ECE411Team15/Speedometer/logs/Images/IMG_20171129_233830.jpg

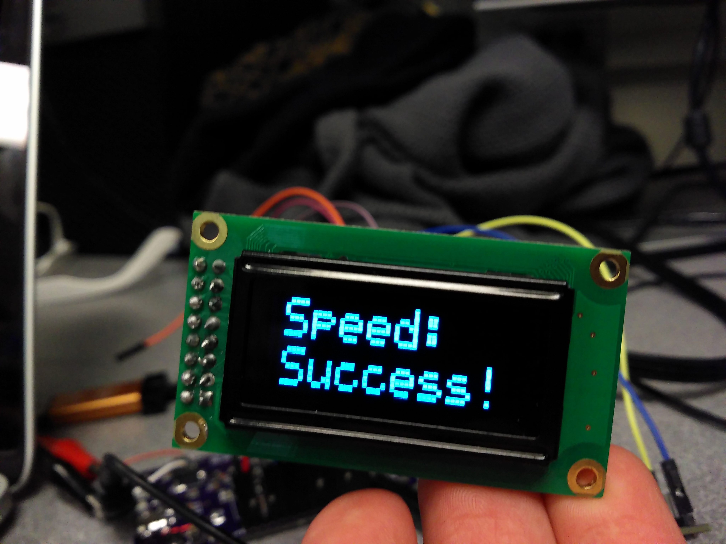
logs/Images/IMG_20171129_233830.jpg
