ECE411Team15/Speedometer/logs/Images/056.jpg

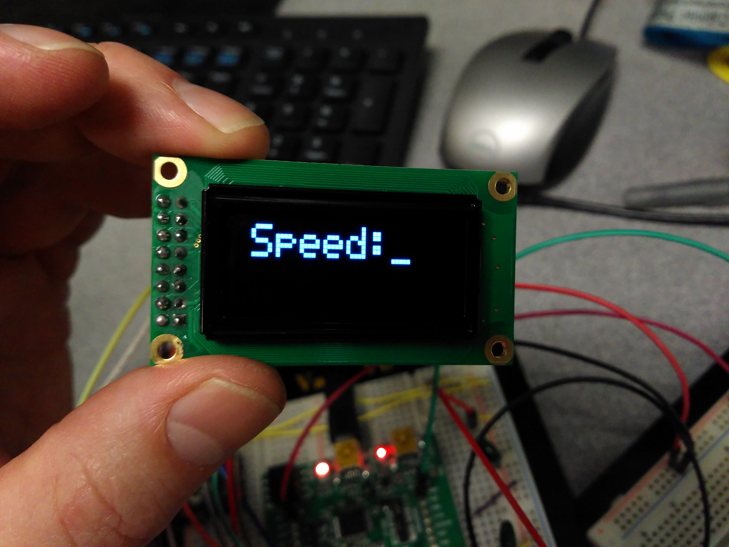
logs/Images/056.jpg
