ECE411Team15/Speedometer/README.md

# Speedometer
ECE 411, Fall 2017, Speedometer project.
