ECE411Team15/Speedometer/link_to_schematic.txt

https://github.com/ECE411Team15/Speedometer/blob/master/EagleCAD/SpeedDemon/Schematic.sch
