ECE411Team15/Speedometer/EagleCAD/On_circuit_timing/proof-of-concept_README.txt

The low voltages at the 'switching' node represent button presses. Notice the momentary press of ~0.4s is sufficient to turn the output voltage on, but not enough to turn it off. Here, the circuit turns off after a ~1.6s press, but it could be made longer or shorter depending on choice of C3 and R3.
The circuit drives the EN input of the voltage regulator, so it will draw almost no current either on or off.

-ZS

NOTE: This circuit is from a commercial site* and we may want to clear its use with Prof. Greenberg.

*source: http://www.mosaic-industries.com/embedded-systems/microcontroller-projects/electronic-circuits/push-button-switch-turn-on/latching-toggle-power-switch

*http://www.mosaic-industries.com/embedded-systems/_detail/microcontroller-projects/electronic-circuits/push-button-switch-turn-on/latching-high-side-toggle-switch-ci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
