ECE411Team15/Speedometer/project_requirements_v1.0.docx

Project Requirements: The Speed Demon

[*If we want to call this something else that’s fine, I just don’t think ‘Speedometer’ is going to cut it. -ZS]

Authors: Linyi Hong, Zachary Stamler, Nathan Dusciuc, Andrew Capatina

Version Number: 1.0

Date Created: 10/15/2017

Needs Statement:

With an infrastructure that supports 350 miles of bikeways, Portland, Oregon is one of the friendliest cities for non-motorized transportation. In Portland, 7.2% of commuters travel by bike. Skateboarding remains a popular pastime, and since the year 2000, skaters there have enjoyed the same legal status as cyclists. Curious bikers may need to know how fast they are moving for many reasons, including safety and timing commutes. Skaters may need to know their speed for completing a jump or for longboarding purposes. The fitness-conscious like to keep track of their distance travelled, and thrill seekers always want to know how fast they are moving. For all these reasons, an adaptable system is needed to record the speed, along with other statistics, of a moving bike or skateboard.

*Statistics provided by the Portland Bureau of Transportation.

Objective Statement:

Our objective is to provide a battery powered device that will display speed for bikes, skateboards, and other wheeled conveyances. The device should work with vehicles with differing wheel diameters, and will be able to switch modes for different units of speed. The user will be able to interact with the device via mode-switch buttons. It will then display the appropriate information on the integrated screen.

Requirements:

Functionality

- Modular, end user-replaceable, chassis mounted Hall effect sensor pairs with wheel-mounted magnet, interfaces with main unit via connector
- Display screen on head unit with large character size, visible in variety of lighting conditions
- Based around STM32F0xxx family MCU
- Head unit must have small form factor, suitable for mounting on bike handlebars or front of skate deck
- Parameterizable, nonvolatile memory stored wheel diameter, ideally with space for several different vehicle specs to allow different modes for different vehicles
- Modes and data entry controllable with two- or three-pushbutton interface

Performance

- Magnet/sensor combination strong enough to leave sensible air gap (~1 cm) between them
- Works at high wheel speeds, up to and exceeding ~30 MPH for small-diameter (i.e. skateboard-sized) wheels. [*Nathan, please check/elaborate on my numbers here! -ZS]
- Battery powered, with power consumption low as possible to restrict size and prolong battery life. Ideally should run on coin battery.
- Water-resistant enough to withstand regular rainy conditions

Economic/Marketing

- Retail cost of device not to exceed $60
- Wheel sensor unit can be sold separately with differing cable lengths and mounting brackets (‘Bike Sensor Kit’, ‘Skate Sensor Kit’, etc)
