ECE411Team15/Speedometer/Presentation/Team15_Presentation_3.0.pptx

## Speed Demon Speedometer

Team15
Andrew Capatina, Zachary Stamler
Nathaniel Dusciuc, Linyi Hong

## Problem/Need

- A simple effective way of measuring speed on a human powered device
  - No off-the-shelf alternatives for skateboards or longboards
  - Cyclists and skateboarders like to measure their own performance and want a device that can do this easily.

To speak: Nathan

## Motivation

- Device allows the user to know their speed
- Dedicated device frees up hands for rider safety
- Allows installation on bicycle, skateboard, longboard, or any other wheeled conveyance
- One device can be used for multiple vehicles

To speak: Nathan

## Objective

- A working prototype that serves as a proof of concept and allows testing of device functionality

To speak: Nathan

## Alternatives

- GPS
  - Dependant on GPS signal
  - Often inaccurate at low speeds
  - Require expensive device or smartphone
- Bicycle speedometers
  - Off-the-shelf speedometers exist for bicycles but they are not compatible with skateboards or other vehicles

To speak: Nathan

## Requirements

- Device measures wheel rotations and displays speed on a screen
- User can choose different units for displayed speed
- User can set wheel size for use with different vehicles
- Device is battery powered

To speak: Nathan

## Approach

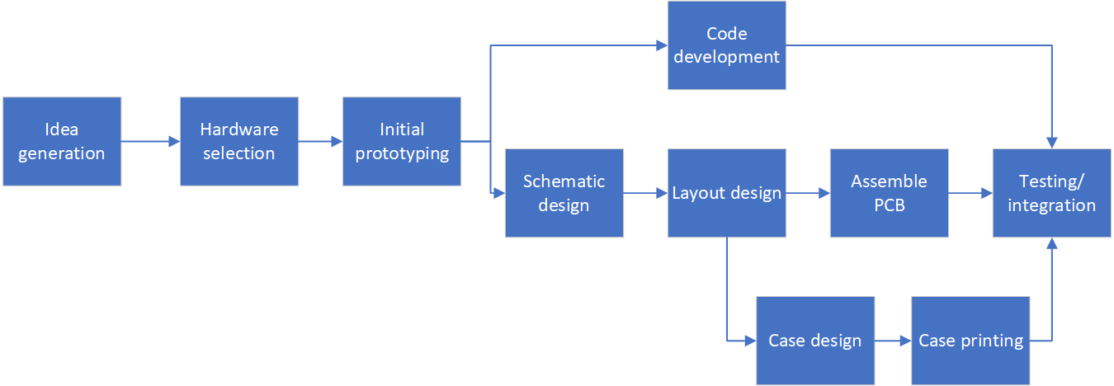
[picture p3: figure]

To speak: Nathan

## Prototyping

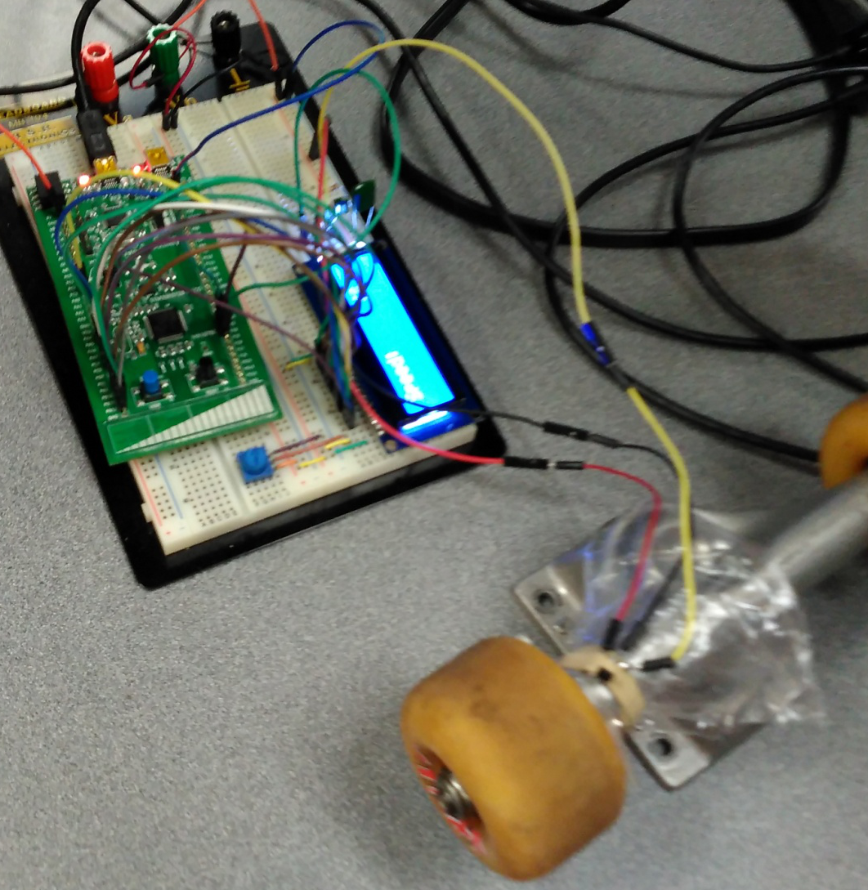
[picture p4: figure]

To speak: Nathan

## Design - Hardware

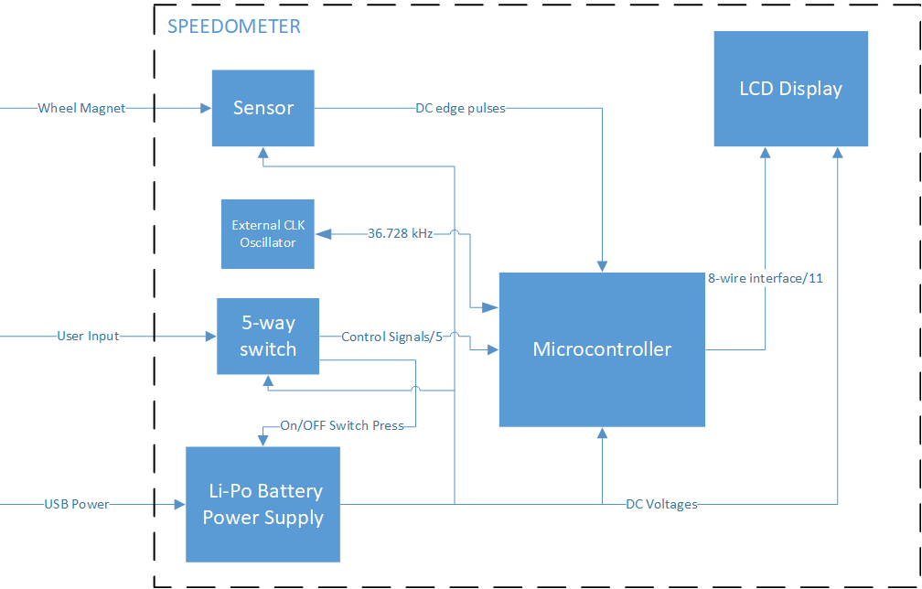
[picture p5: figure]

To speak: Zach

## Slide 10

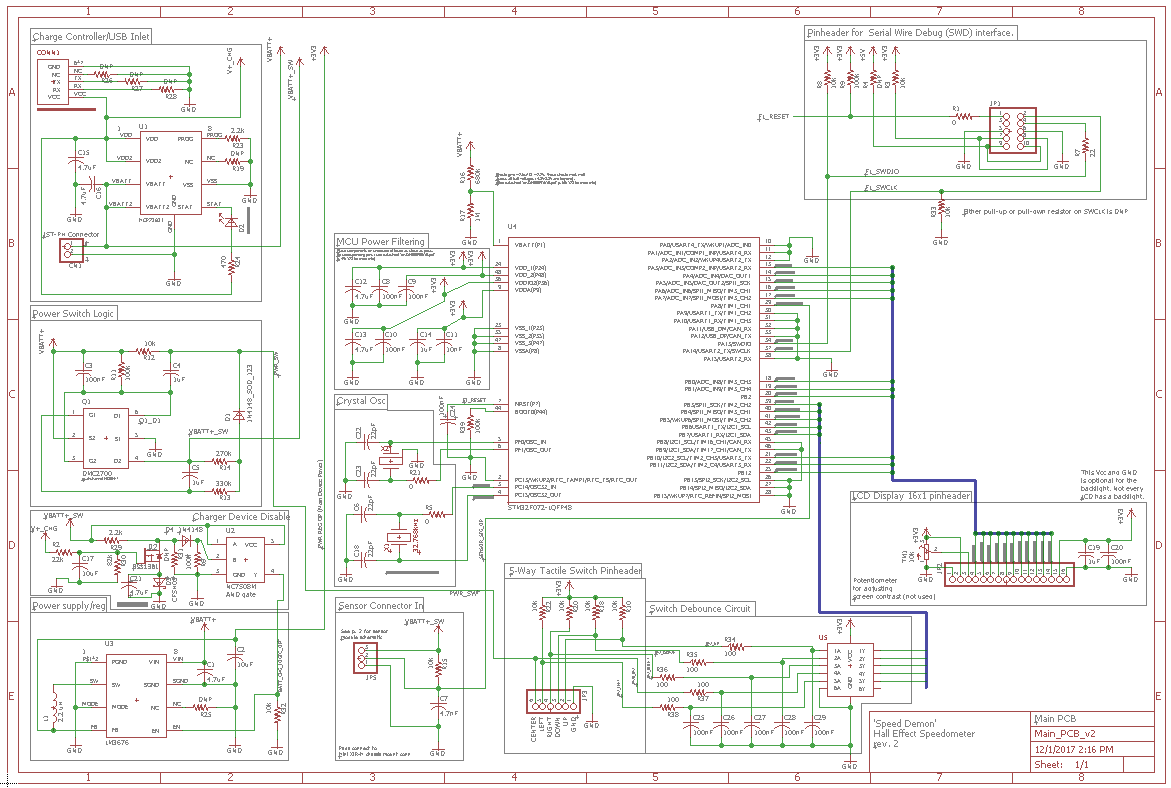
[picture p6: figure]

Schematic

To speak: Zach

## Hardware PCB Layout

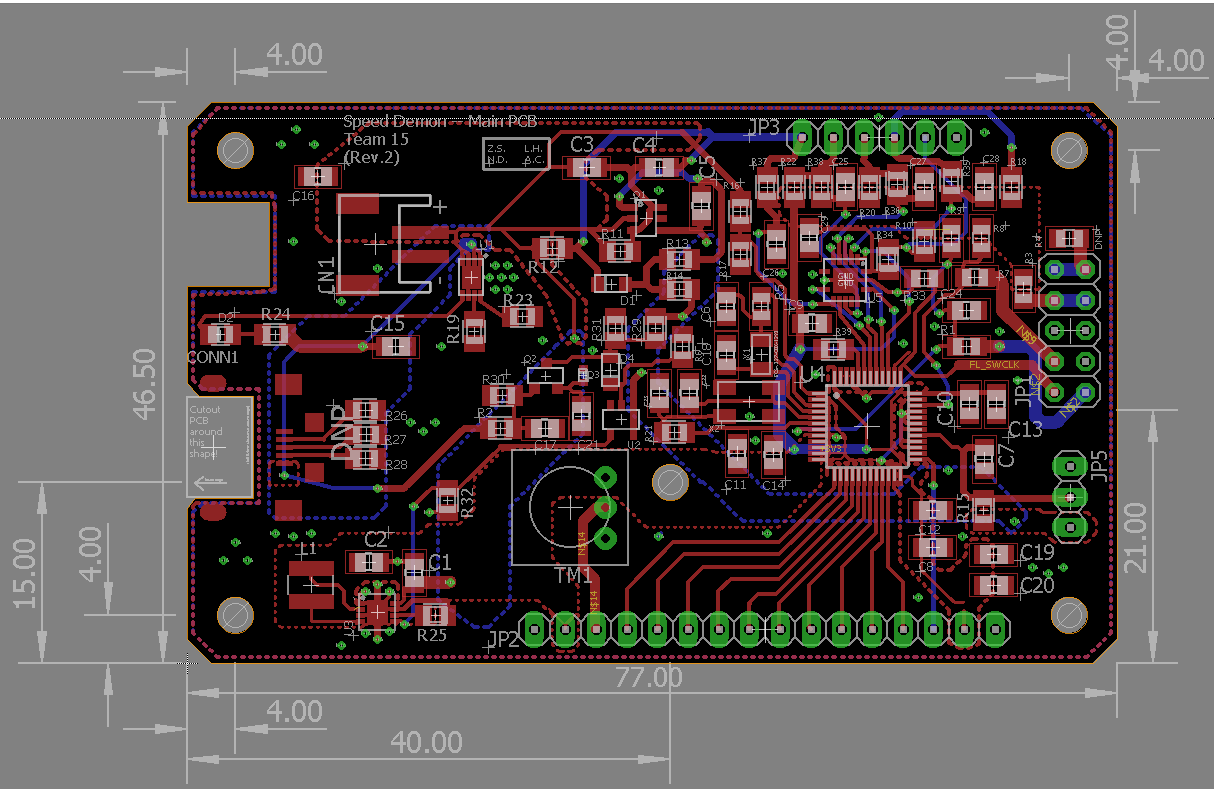
[picture p7: figure]

To speak: Zach

## High Level Software Implementation

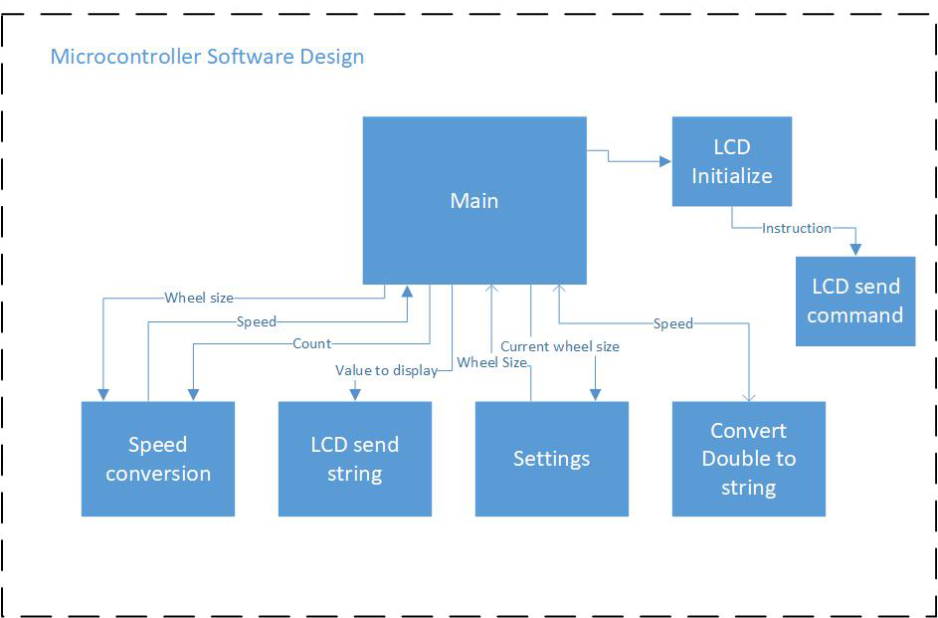
[picture p8: figure]

To speak: Andrew

## Software Implementation - User Program

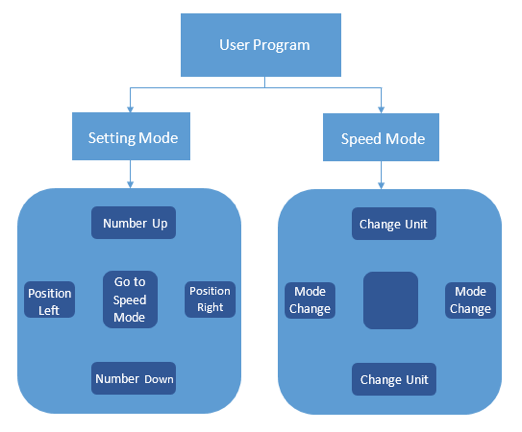
[picture p9: figure]

To speak: Andrew

## Design Alternatives?

Module | Option 1 | Option 2
Speed Conversion | Polling Hall Effect Sensor Input | Interrupts (input capture)
Settings | Polling button inputs | Interrupts

What are the tradeoffs?
- Polling requires extra effort for timing
  - Not utilizing available resources as well
Decisions Made:
- Speed Conversion: option 2
- Settings: option 2

To speak: Andrew

## Software Development Tools

- MCU hardware configuration:
  - STM32CubeMX
- Compiler/debugger
  - Keil uVision IDE.
- Development Board
  - STM32F072B-DISCOVERY

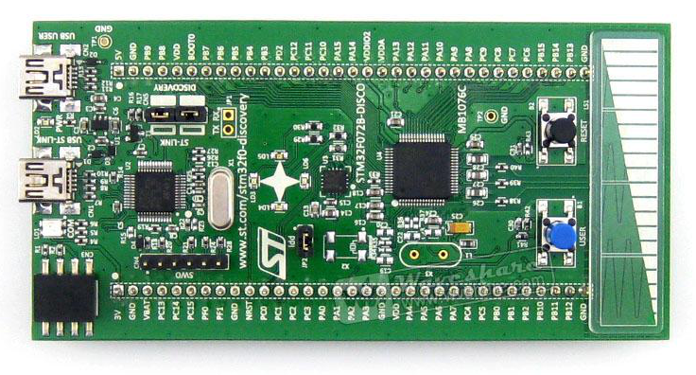
[picture p10: figure]

To speak: Andrew

## Work referenced for Software

- Patrick Hood-Daniel
  - Provided program structure for OLED program.
- Le Tan Phuc
  - Provided tutorial on how to initialize input capture.
- Links:
  - https://letanphuc.net/2015/06/stm32f0-timer-tutorial-and-counter-tutorial/ (https://letanphuc.net/2015/06/stm32f0-timer-tutorial-and-counter-tutorial/)
  - https://www.youtube.com/watch?v=micDbBN9s9k&list=PL6PplMTH29SHbfyqpSqn-2gyJZtuwzEqs

To speak: Andrew

## Bill of Materials…

To speak: Linyi

## Testing

1. Bring up sub-circuits in sequence and verify correct functionality of each.
2. Interface MCU and test dummy code.
3. Integrate hardware modules with fully functioning code.

To speak: Linyi

## Software Test Plan

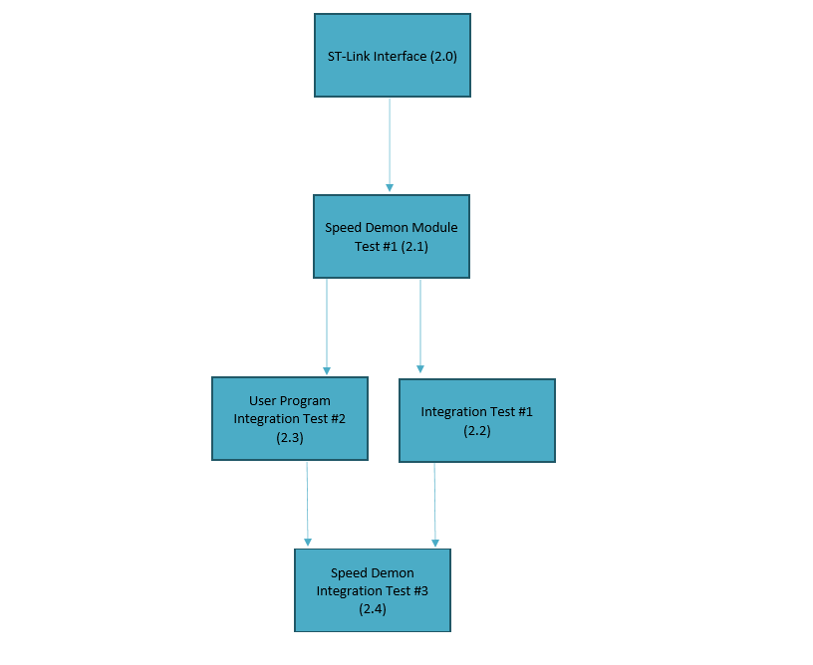
[picture p11: figure]

To speak: Linyi

## Results

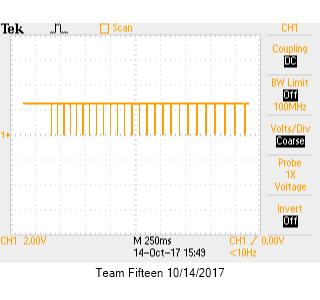
[picture p12: figure]

Hall effect sensor prototyping

To speak: Linyi

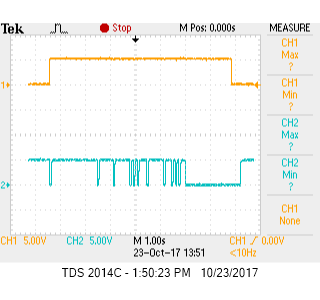
[picture p13: figure]

On-button prototyping

## Slide 21

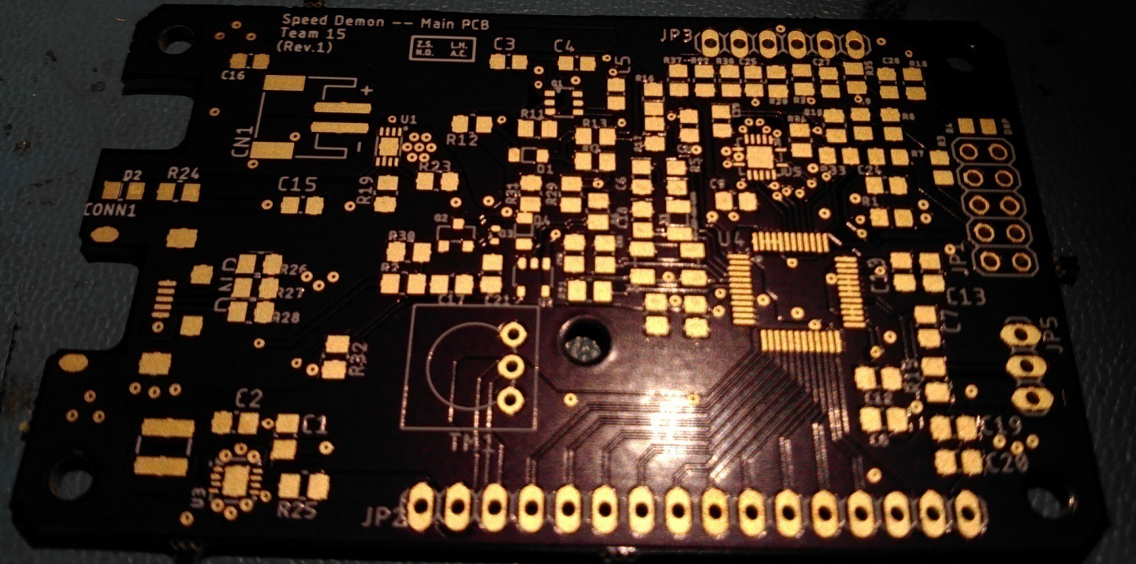
[picture p14: figure]
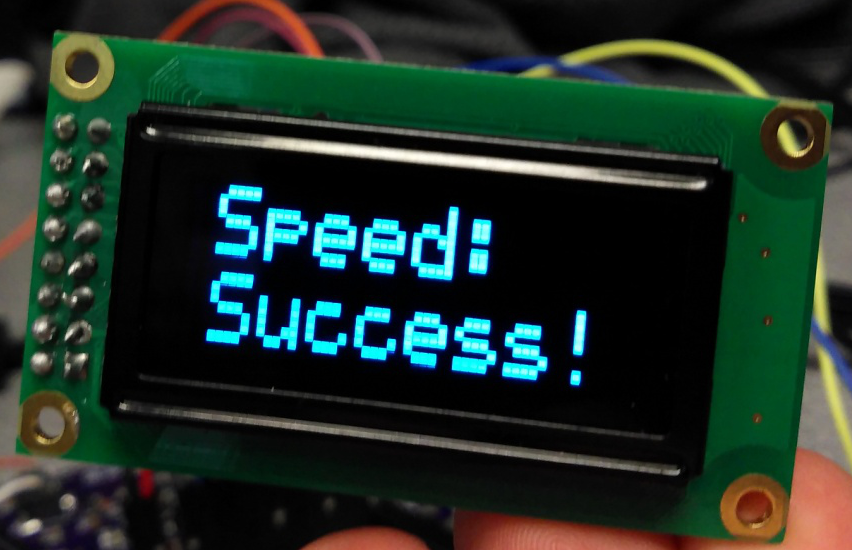
[picture p15: figure]

To speak: Linyi

## Contributions

- N.D.
- Hardware design
- Schematic and layout
- Part sourcing
- Testing
- Board bring up

To speak: Linyi

- Z.S.
- Hardware design
- Schematic and layout
- EagleCAD custom parts
- Part sourcing
- Testing
- Board bring up

- A.C.
- Software Design
- Part sourcing
- Testing software
- speedDemon software integration

- L.H.
- Software design
- Testing software
- Hardware design
- Case design

## Lessons Learned?

To speak: All
