ECE411Team15/Speedometer/Presentation/Team15_Presentation_2.0.pptx

## Speed Demon Speedometer

Team15
Andrew Capatina, Zachary Stamler
Nathaniel Dusciuc, Linyi Hong

## Problem/Need

- A simple effective way of measuring speed on a human powered device
  - No off-the-shelf alternatives for skateboards or longboards
  - Cyclists and skateboarders like to measure their own performance and want a device that can do this easily.

To speak: Nathan Dusciuc

## Motivation

- Device allows the user to know their speed
- Dedicated device frees up hands for rider safety
- Allows installation on bicycle, skateboard, longboard, or any other wheeled conveyance
- One device can be used for multiple vehicles

To speak: Nathan Dusciuc

## Objective

- A working prototype that serves as a proof of concept and allows testing of device functionality

To speak: Zach Stamler

## Alternatives

- GPS
  - Dependant on GPS signal
  - Often inaccurate at low speeds
  - Require expensive device or smartphone
- Bicycle speedometers
  - Off-the-shelf speedometers exist for bicycles but they are not compatible with skateboards or other vehicles

To speak: Zach Stamler

## Requirements

- Device measures wheel rotations and displays speed on a screen
- User can set wheel size for use with different vehicles
- User can choose different units for displayed speed
- Device is battery powered

To speak: Zach Stamler

## Approach


To speak: Linyi Hong

## Software Development Test Rig


To speak: Andrew Capatina

## Design - Hardware


To speak: Nathan Dusciuc

## Slide 10


Schematic

To speak: Zach Stamler

## High Level Software Implementation


To speak: Andrew Capatina

## Software Implementation - User Program


To speak: Linyi Hong

## Design Alternatives?

Module | Option 1 | Option 2
Speed Conversion | Polling Hall Effect Sensor Input | Interrupts (input capture)
Settings | Polling button inputs | Interrupts

What are the tradeoffs?
- Polling requires extra effort for timing
  - Not utilizing available resources as well
Decisions Made:
- Speed Conversion: option 2
- Settings: option 2

To speak: Andrew Capatina

## Hardware PCB Layout


To speak: Zach Stamler

## Software Development Tools

- MCU hardware configuration:
  - STM32CubeMX
- Compiler/debugger
  - Keil uVision IDE.
- Development Board
  - STM32F072B-DISCOVERY


To speak: Andrew Capatina

## Work referenced for Software

- Patrick Hood-Daniel
  - Provided program structure for OLED program.
- Le Tan Phuc
  - Provided tutorial on how to initialize input capture.

To speak: Andrew Capatina

## Bill of Materials…

To speak: Nathan Dusciuc

## Testing

1. Bring up sub-circuits in sequence and verify correct functionality of each.
2. Interface MCU and test dummy code.
3. Integrate hardware modules with fully functioning code.

To speak: Linyi Hong

## Software Test Plan


To speak: Andrew Capatina

## Results


Hall effect sensor prototyping

To speak: Nathan Dusciuc


On-button prototyping

## Slide 21


## Contributions

- N.D.
- Hardware design
- Schematic and layout
- Part sourcing
- Testing
- Board bring up

- Z.S.
- Hardware design
- Schematic and layout
- EagleCAD custom parts
- Part sourcing
- Testing
- Board bring up

- A.C.
- Software Design
- Part sourcing
- Testing software
- speedDemon software integration

- L.H.
- Software Design
- Testing Software
- Hardware design
- Case Design

## Lessons Learned?

- Andrew Capatina: slow down, show more confidence in problem solving.
- Communication is key when working with others to implement software

To speak: All
