ECE411Team15/Speedometer/WPRs/wk09_Dusciuc_WPR.docx

# Weekly Report

Nathaniel Dusciuc

Week 9

11/27/17

# What I did:

- Wrote hardware test cases with Zach.
- Helped Andrew debug issue with input sampling time and speed conversion formula.
- Ordered female/female jumper wires from Adafruit.
- Received PCBs from OSH Park.
- Received Li-Po batteries from Adafruit.

# Issues:

- We need joystick caps for our 5-way tactile switches.

# Next Steps:

- Bring up PCB.
- Finish test plan for homework 7
- Help design case enclosure.
