ECE411Team15/Speedometer/WPRs/wk08_Dusciuc_WPR.docx

# Weekly Report

Nathaniel Dusciuc

Week 8

11/20/17

# What I did:

- Soldered sic 5-way tactile switches to six breakout boards.
- Ordered four Lithium polymer batteries and six right-angle JST-PH battery connectors.
- Tested sensor modules in the housing that Zach made.
- Helped Linyi and Andrew with prototyping.
- Ordered resistors and capacitors with Zach.

# Issues:

- We need joystick caps for our 5-way tactile switches.

# Next Steps:

- Bring up PCB.
- Write test plan for homework 7.
- Order female/female jumpers for assembling LCD screens to main PCBs.
