ECE411Team15/Speedometer/WPRs/wk07_Dusciuc_WPR.docx

# Weekly Report

Nathaniel Dusciuc

Week 7

11/12/17

# What I did:

- Zach and I finished the board layout.
- I created block diagrams of our project for the “Detailed Design” homework assignment.
- Zach and I tried to solder some components for prototyping but the components are too small.
- Purchased red-wire for prototyping/debugging.

# Next Steps:

- Help Andrew and Linyi with prototyping.
- Solder 5-way tactile switches to their breakout boards for prototyping.
- Review pinout with team and modify eaglecad files as needed.
