ECE411Team15/Speedometer/WPRs/wk06_Dusciuc_WPR.docx

# Weekly Report

Nathaniel Dusciuc

Week 6

11/4/17

# What I did

- I helped Zachary revise the schematic and verify a final version.
- I met with my team and we completed our project plan using Microsoft project.
- I did a breakout board layout for the 5-way tactile switch we will be using. Zachary ordered the board from OSHPark.
- I started the preliminary board layout for our main board.
- Purchased six 5-way tactile switches from Sparkfun.
- Purchased two 1x40 headers from EPL.

# Next Tasks

- Work with Zachary to complete a preliminary board layout.
- Work with my team to create a block diagram depicting the inputs and outputs of our design.
- I need to order more key components for further prototyping.
