ECE411Team15/Speedometer/WPRs/wk05_Dusciuc_WPR.docx

# Weekly Report

Nathaniel Dusciuc

Week 5

10/29/17

# What I did

Zachary and I finished the draft of the schematic.

I helped Andrew build a prototype of our product using the STM32 development board.

I worked with Zachary and Linyi to finish the decision matrix document for the homework assignment.

# Next Tasks

I need to revise the schematic and create a final version.

We need to collaborate as a team to create a Microsoft project document showing our plan.
