ECE411Team15/Speedometer/logs/Ways to flash the MCU.docx

Ways to flash the MCU:

# Serial Wire Debug (SWD) (Use ST-link V2) （Recommend, design for STM32）

# Actually, one common way to interface chips is JTAG, which require 20 lines:

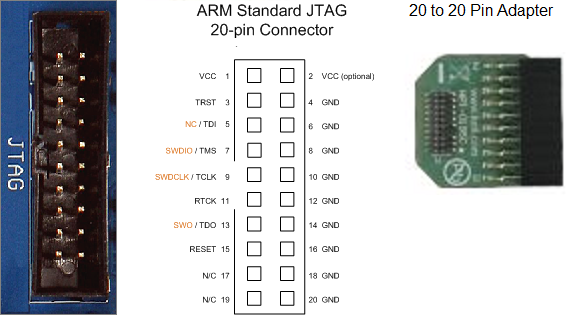
[picture p16: figure]
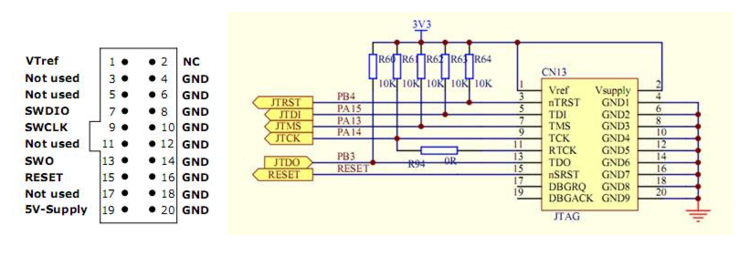
[picture p17: figure]

But JTAG connector is very expensive, so when we use STM32, we can use another interface way which can also done in JTAG. It called Serial Wire Debug (SWD). SWD is an alternative 2-pin electrical interface that uses the same protocol. It uses the existing GND connection. On JTAG devices with SWD capability, the TMS and TCK are used as SWDIO and SWCLK signals, providing for dual-mode programmers.

# SWD only requires 4 lines:

# Transferring data must use three wire: SWDIO, SWCLK and GND (common ground with the MCU). VDD pins make MCU and ST-link board common VDD. Reset is reset….

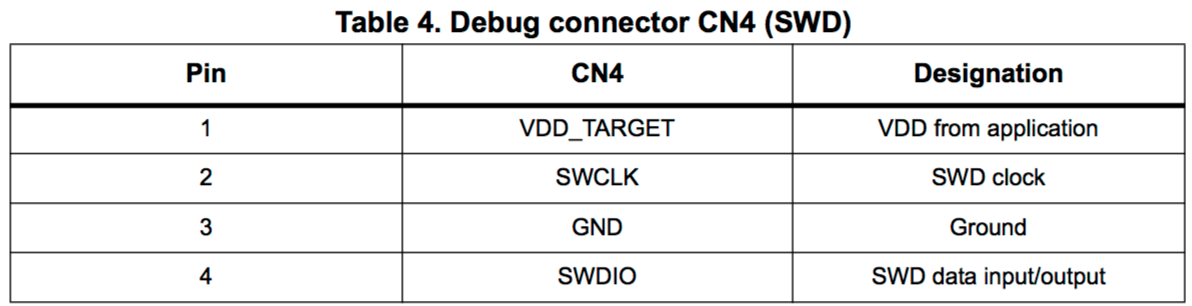
[picture p18: figure]

# We don't need SWO here.

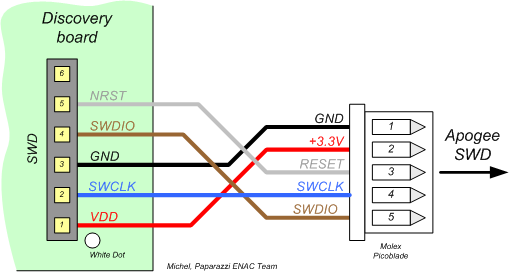
[picture p19: figure]

# I found a lot of schematic on the internet, some schematics for the SWD part connect 10k resistors. But some just connect them directly. The pictures are showing below,

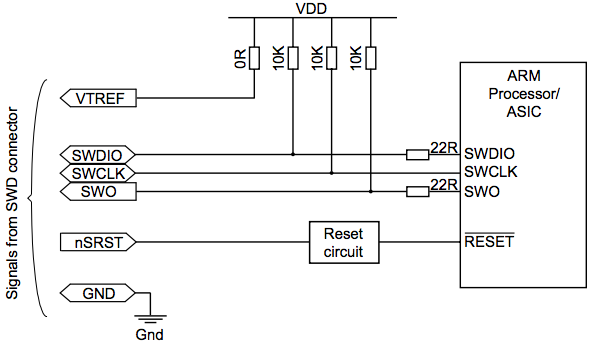
[picture p20: figure]

# Current requirement for VDD(3.3) is no more than 300mA, VDD(5V) is no more than 400mA.

Component: https://www.adafruit.com/product/2548?gclid=EAIaIQobChMI0-69o7T51gIVDzNpCh2flQ4BEAQYAiABEgIE7_D_BwE

and download the drive (st-link_v2_usbdriver.exe) and specific software (STM32 ST-link Utility).

# Serial interface (Use CH340G)

Component: http://www.dx.com/p/stc-stm32-ch340g-upgraded-usb-to-ttl-downloader-green-389333#.WecN3hNSxHU (do not include BOOT0 pin)

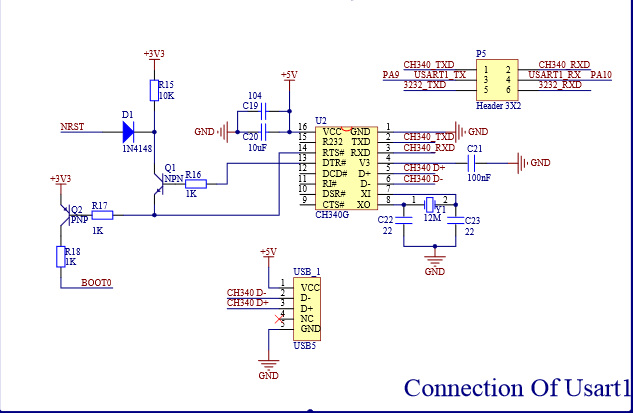
[picture p21: figure]

and download the drive and specific software on computer to load the code.

But both ways we need to find out a way to control BOOT0 pin on MCU to make sure the mode is right.

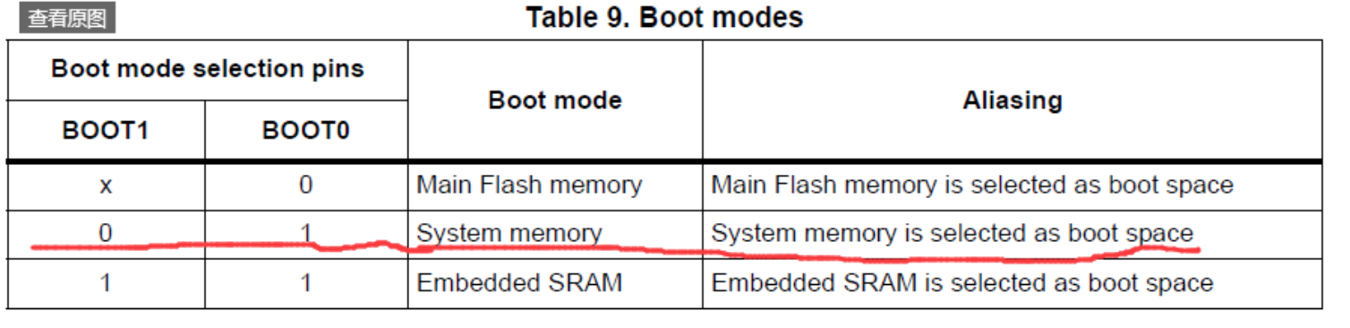
[picture p22: figure]
