ECE411Team15/Speedometer/Case/Mechanicals for case design/images_LOOK_HERE_FIRST/battery.pdf

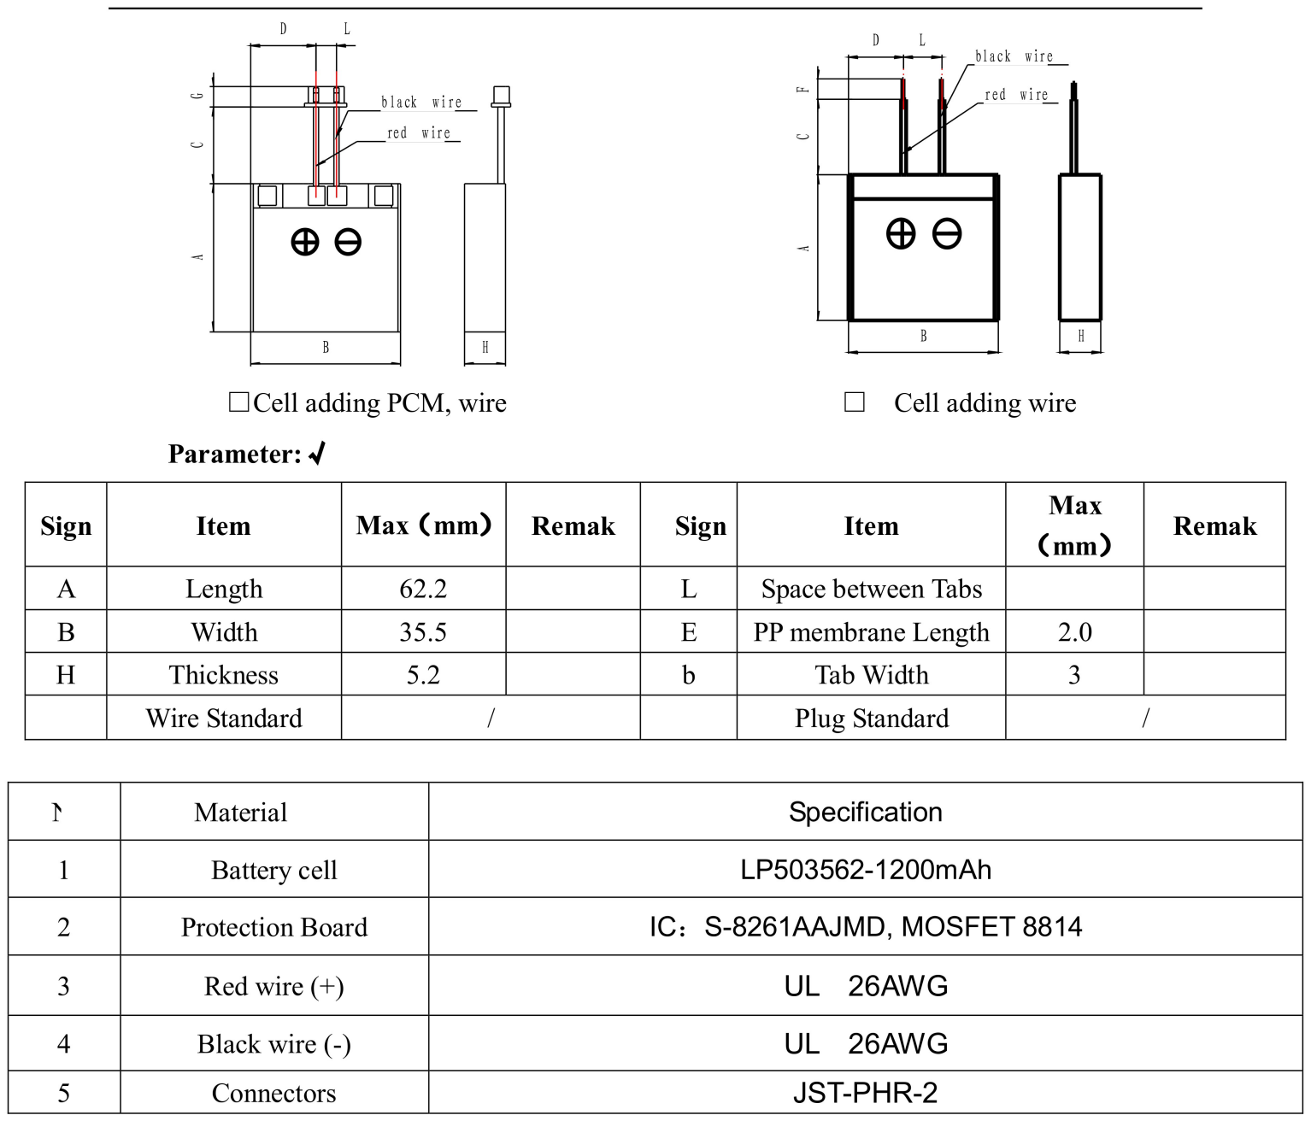
[picture p28: page 1]
