ECE411Team15/Speedometer/Block diagram.PNG

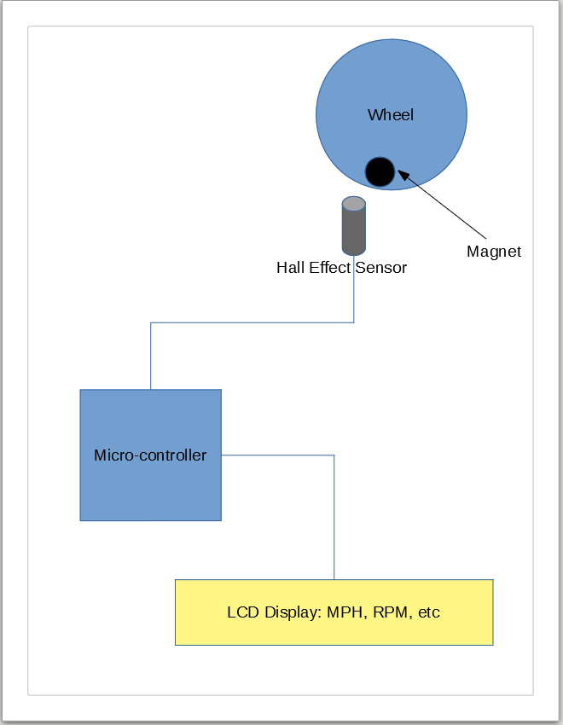
Block diagram.PNG
