ECE411Team15/Speedometer/Case/Mechanicals for case design/images_LOOK_HERE_FIRST/Main_PCB.png

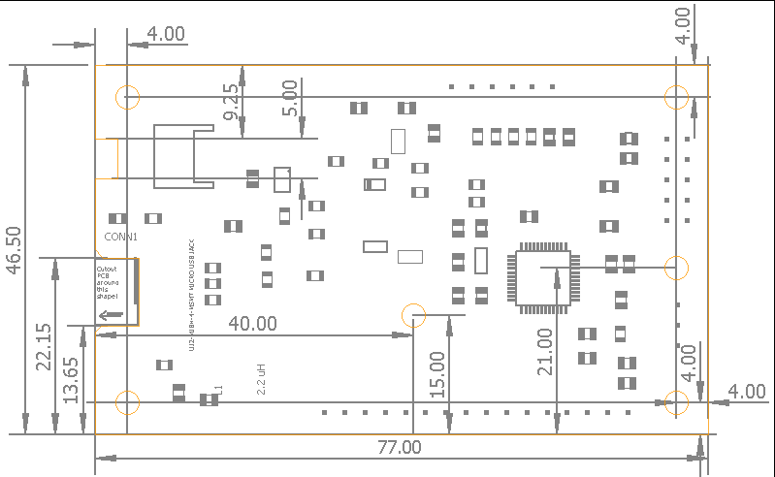
Case/Mechanicals for case design/images_LOOK_HERE_FIRST/Main_PCB.png
