ECE411Team15/Speedometer/Case/Mechanicals for case design/images_LOOK_HERE_FIRST/tactile_switch.png

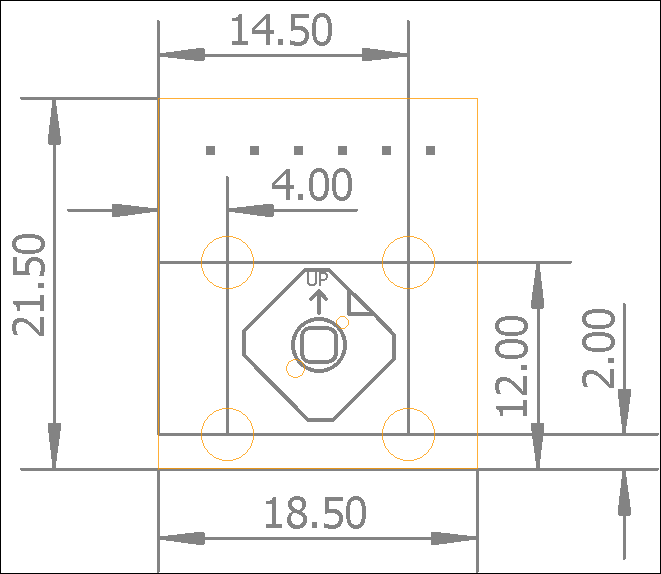
Case/Mechanicals for case design/images_LOOK_HERE_FIRST/tactile_switch.png
