ECE411Team15/Speedometer/EagleCAD/On_circuit_timing/proof-of-concept.png

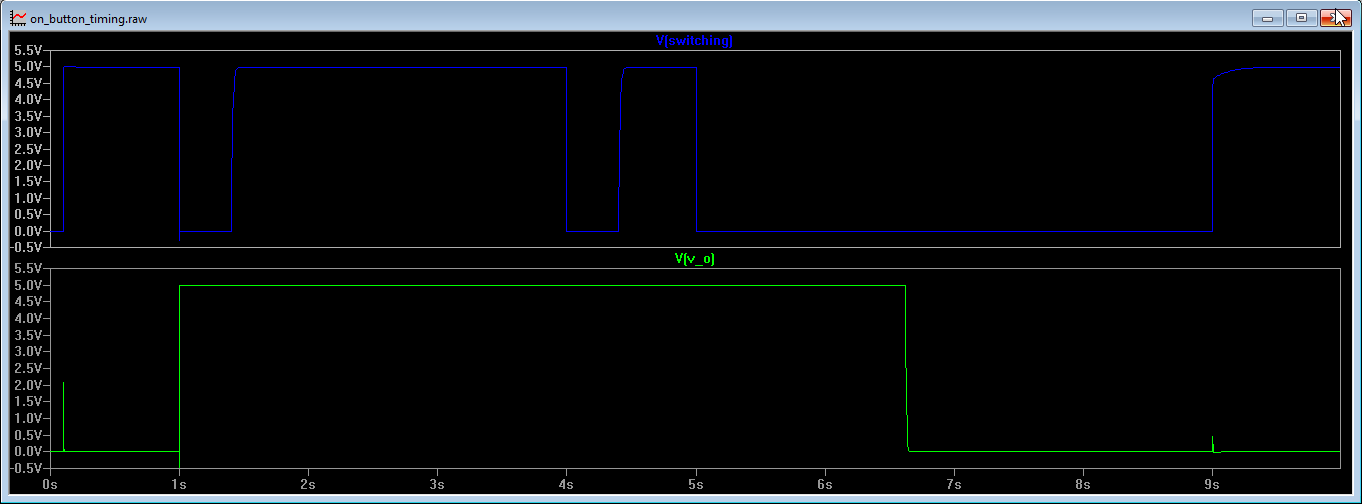
EagleCAD/On_circuit_timing/proof-of-concept.png
