ECE411Team15/Speedometer/logs/Images/3Dprint.jpg

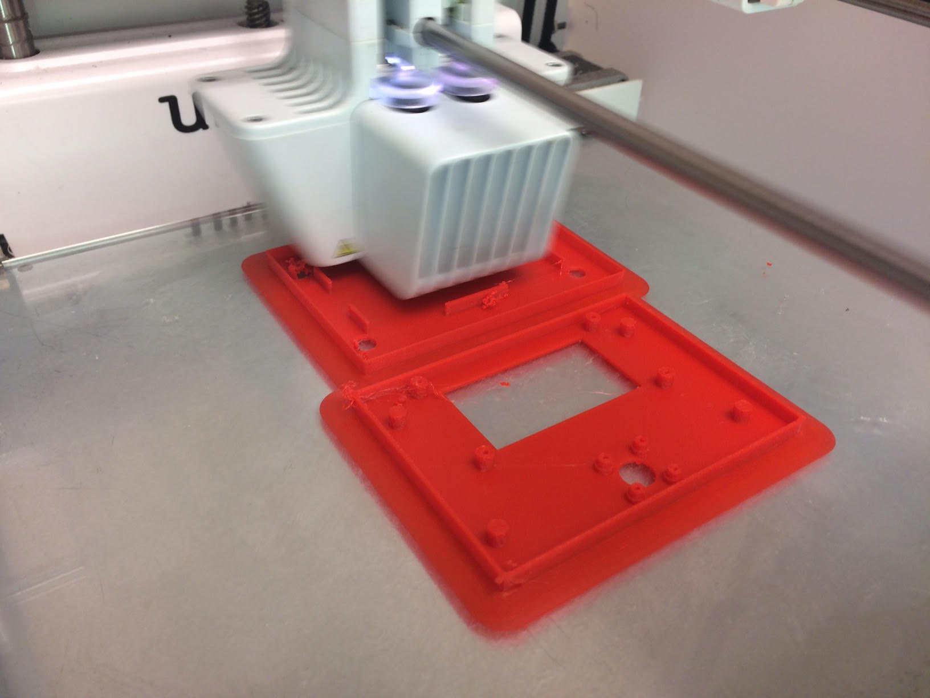
logs/Images/3Dprint.jpg
