ECE411Team15/Speedometer/logs/Images/042.jpg

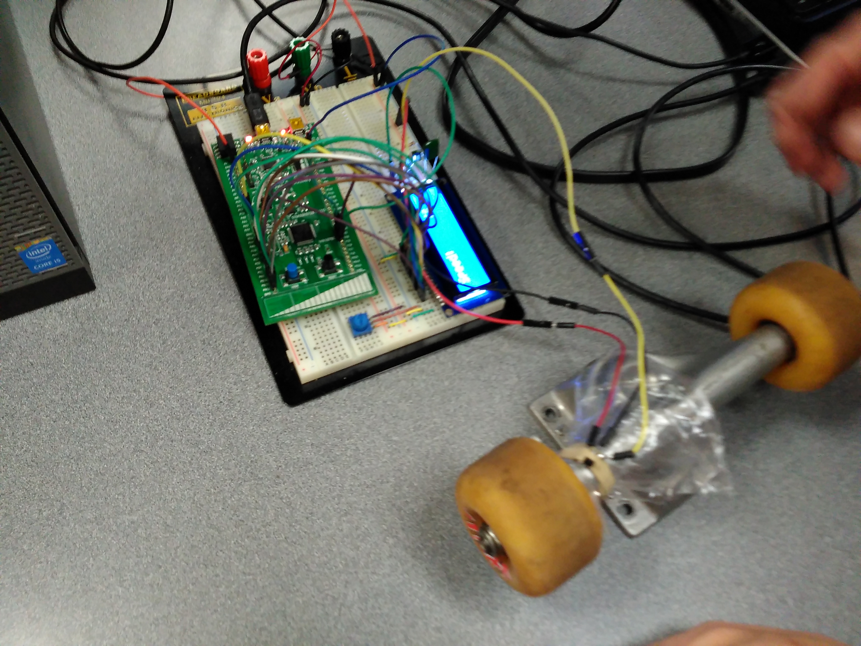
logs/Images/042.jpg
