ECE411Team15/Speedometer/logs/Images/device_off_CHG_pwr_applied.bmp

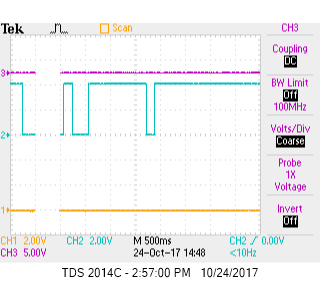
logs/Images/device_off_CHG_pwr_applied.bmp
