ECE411Team15/Speedometer/logs/Images/IMG_20171122_155730.jpg

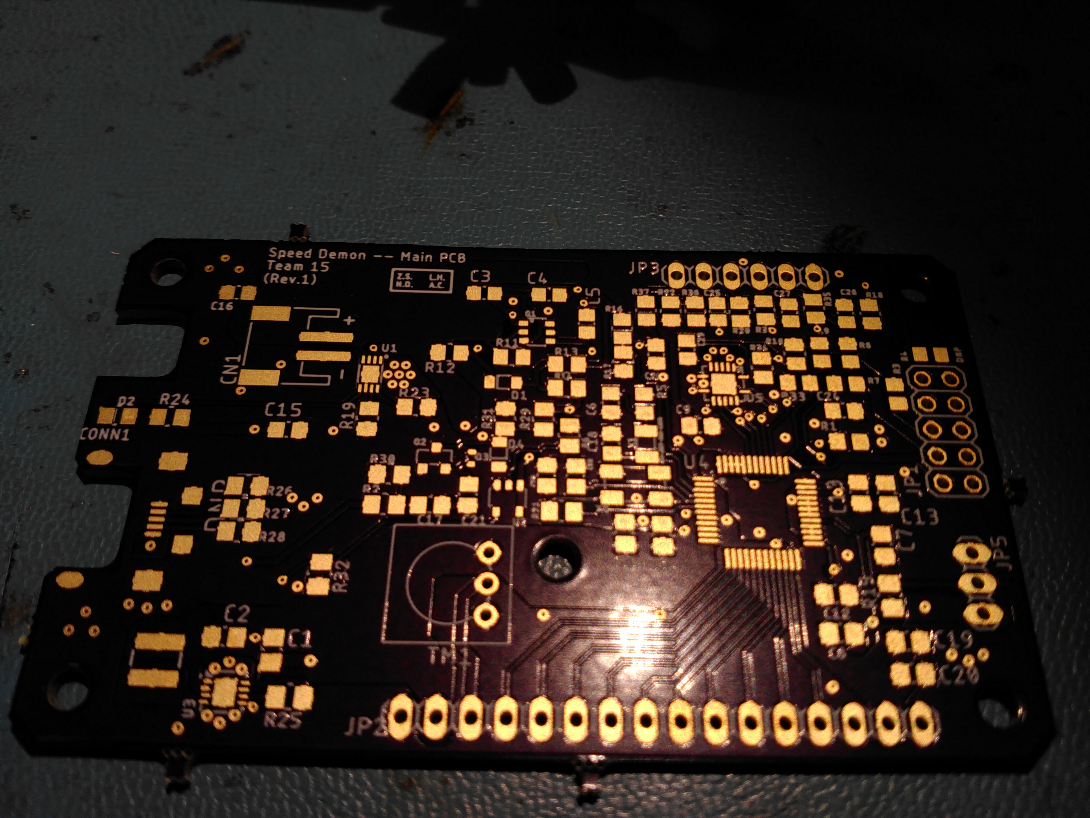
logs/Images/IMG_20171122_155730.jpg
