ECE411Team15/Speedometer/logs/Images/IMG_20171128_145334.jpg

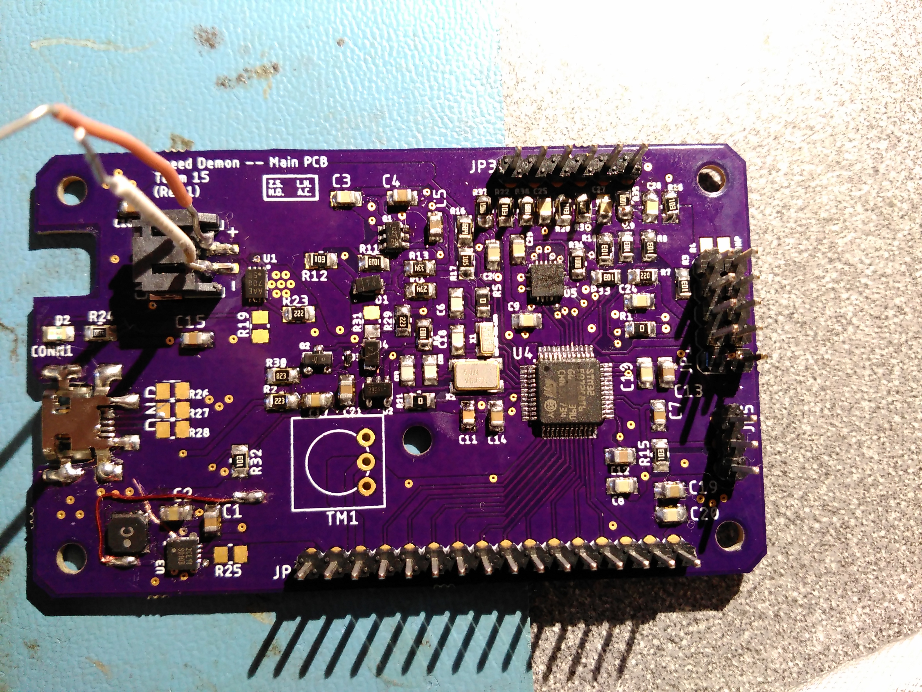
logs/Images/IMG_20171128_145334.jpg
