ECE411Team15/Speedometer/logs/Images/sensor prototyping (2).jpg

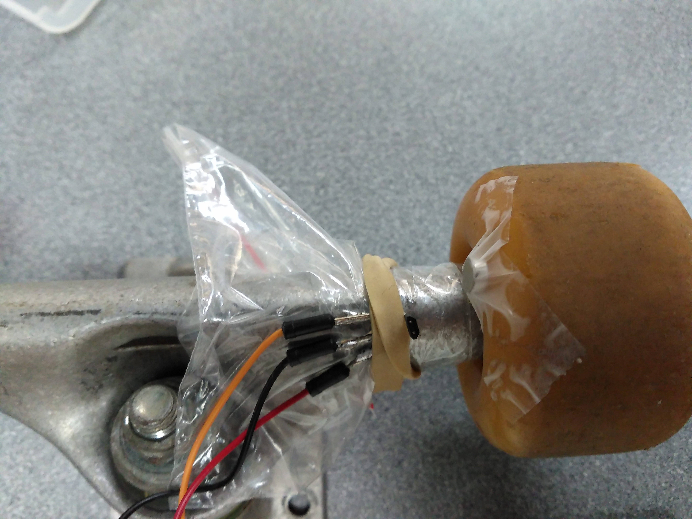
logs/Images/sensor prototyping (2).jpg
