ECE411Team15/Speedometer/logs/Images/sensor prototyping (3).jpg

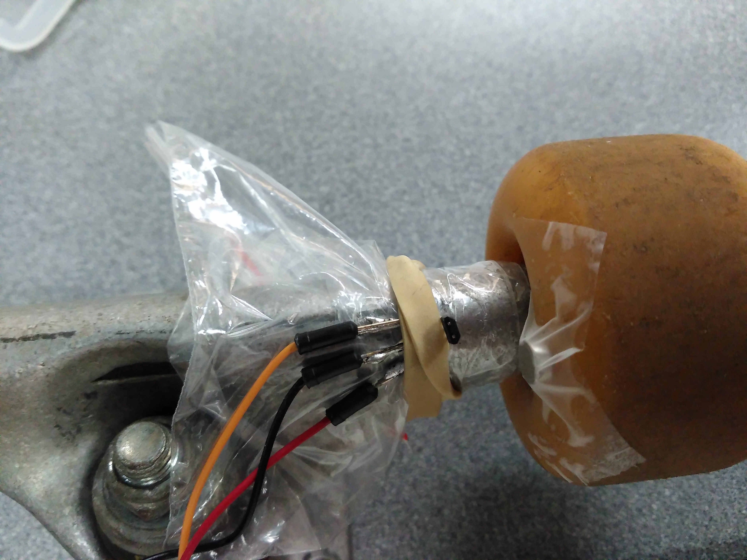
logs/Images/sensor prototyping (3).jpg
