ECE411Team15/Speedometer/sample.bmp

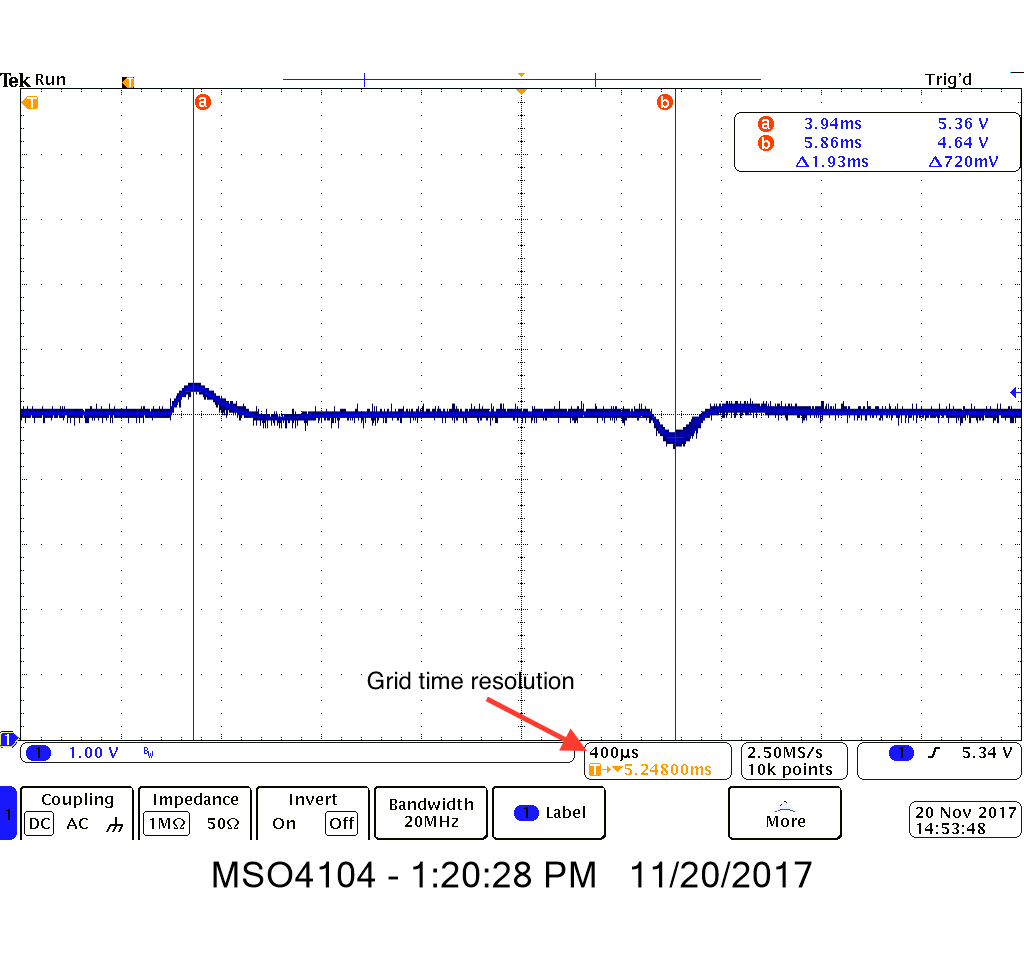
sample.bmp
