ECE411Team15/Speedometer/EagleCAD/Mechanical drawings for parts libs/rj_6.pdf

a | 6-Lead Small Outline Transistor Package [SOT-23] (RJ-6) Dimensions shown in millimeters

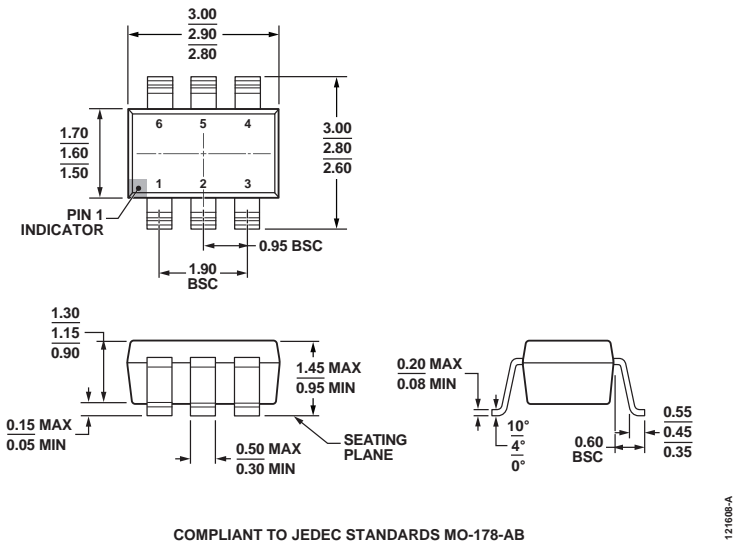
[picture p43: figure]
PIN 1 INDICATOR; BSC; 0.95 BSC; 1.45 MAX 0.95 MIN; 0.50 MAX; 0.20 MAX 0.08 MIN; 0.55 0.15 MAX; 0.45 SEATING; PLANE; BSC 0.05 MIN; 0.30 0° MIN; COMPLIANT TO JEDEC STANDARDS MO-178-AB
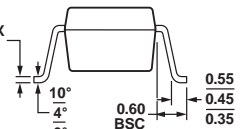
[picture p44: figure]
