ECE411Team15/Speedometer/Bill of Material v.3.xlsx

Bill Of Material |  |  |  |  |  |  | TOTAL PER TEAM MEMBER
Part number | Quantitiy | Unit price | Price | Supplier | Purchaser | Remarks/Description | 109.165
US5881TO-92 | 5 | 1 | 5 | EPL | Nathan | Working Hall Effect Sensors
A3212EUA-T | 6 | 0.52 | 3.1 |  | Nathan | Not Working Hall Effect Sensors | COST OF SINGLE UNIT
RED T3BM | 1 | 3.98 | 3.95 | REDCO | Zach | Panel-mount male mini-XLR connector | 62.832
RED TA3FB-S | 1 | 5.25 | 5.25 | REDCO | Zach | Cable-mount female mini-XLR connector
MAR W2944 | 12 (feet) | 0.87 | 3.48 | REDCO | Zach | Mogami 3-conductor console cable | Zach spent
SHIP |  |  | 3.05 | USPS | Zach | Redco order | $274.34
N/A | 1 |  | 9 | Lab | Zach | Dev MCU breakout board
JST-PH 2-Pin SMT Right Angle Connector | 4 | 0.75 | 3 | Adafruit | Nathan | Six JST-PH connectors | Nathan spent
Lithium Ion Polymer Battery - 3.7v 1200mAh | 4 | 9.95 | 39.8 | Adafruit | Nathan | Four Li-Po batteries | 78.34
5-way Tactile Switch | 6 | 2.9 | 17.44 | Sparkfun | Nathan | Six 5-way tactile switches.
SHIP |  |  | 7.5 | USPS | Zach |  | Andrew spent
ST-Link V2 Programmer/Emulator | 1 |  | 15.53 |  | Andrew | Programmer for MCU | 83.98
Discover Kit for STM32F072B | 1 |  | 15.24 |  | Andrew | Development board
IC MCU STM32F072C8 | 3 | 4.16 | 12.48 |  | Andrew | Standalone MCU
Assembled Standard LCD 16x2 | 1 |  | 15.48 |  | Andrew | Remark: Prototype LCD
8x2 Blue Character OLED | 1 |  | 16.4 |  | Andrew | LCD to be used for final product
Main PCB | 4 | 6.93 | 27.75 | OSH Park | Zach
Solder stencil + solder paste | 1 ea |  | 47.49 | OSH Stencils | Zach | Shipping Incl
Remainder of connectors |  |  | 32.7 | Redco | Zach | shipping incl
Female/Female Jumper wires 40x3" | 2 | 2.5 | 10 | Adafruit | Nathan | Two sets of 40 female/female jumper wires.
LM3676SD-3.3/NOPBCT-ND | 10 | 1.313 | $13.13 | Digikey | Zach | IC REG BUCK 3.3V 0.6A SYNC 8WSON
NC7S08M5XCT-ND | 10 | 0.309 | $3.09 | Digikey | Zach | IC GATE AND 1CH 2-INP SOT-23-5
MCP73831-2ACI/MC-ND | 7 | 0.62 | $4.34 | Digikey | Zach | IC CONTROLLER LI-ION 4.2V 8DFN
BSS138LT1GOSCT-ND | 10 | 0.261 | $2.61 | Digikey | Zach | MOSFET N-CH 50V 200MA SOT-23
DMC2700UDM-7CT-ND | 10 | 0.567 | $5.67 | Digikey | Zach | MOSFET N/P-CH 20V SOT26
102-4008-1-ND | 6 | 1.16 | $6.96 | Digikey | Zach | USB JACK 2.0, MICRO B TYPE, 5 PI
XC2292CT-ND | 10 | 0.495 | $4.95 | Digikey | Zach | CRYSTAL 32.7680KHZ 12.5PF SMD
587-3566-1-ND | 6 | 0.56 | $3.36 | Digikey | Zach | FIXED IND 2.2UH 1.5A 102 MOHM
495-6939-1-ND | 1 | 0.45 | $0.45 | Digikey | Zach | FIXED IND 2.2UH 3.4A 57 MOHM TH
XC2121-ND | 1 | 0.6 | $0.60 | Digikey | Zach | CRYSTAL 32.768KHZ 12.5PF TH
311-3569-1-ND | 100 | 0.0305 | 3.05 | Digikey | Zach | CAP CER 0.1UF 50V X7R 0805
1276-1065-1-ND | 35 | 0.107 | 3.75 | Digikey | Zach | CAP CER 4.7UF 16V X5R 0805
311-10KARCT-ND | 100 | 0.0076 | 0.76 | Digikey | Zach | RES SMD 10K OHM 5% 1/8W 0805
311-100CRCT-ND | 100 | 0.0088 | 0.88 | Digikey | Zach | RES SMD 100 OHM 1% 1/8W 0805
478-10510-1-ND | 25 | 0.221 | 5.53 | Digikey | Zach | CAP CER 22PF 50V NP0 0805
490-1691-1-ND | 20 | 0.083 | 1.66 | Digikey | Zach | CAP CER 1UF 16V X7R 0805
RMCF0805JT2K20CT-ND | 20 | 0.017 | 0.34 | Digikey | Zach | RES SMD 2.2K OHM 5% 1/8W 0805
490-10498-1-ND | 16 | 0.131 | 2.10 | Digikey | Zach | CAP CER 10UF 16V X6S 0805
311-100KCRCT-ND | 16 | 0.022 | 0.35 | Digikey | Zach | RES SMD 100K OHM 1% 1/8W 0805
311-0.0ARCT-ND | 100 | 0.0071 | 0.71 | Digikey | Zach | RES SMD 0 OHM JUMPER 1/8W 0805
CFSH05-20L CT-ND | 10 | 0.414 | 4.14 | Digikey | Zach | DIODE SCHOTTKY 20V 500MA SOD882
RMCF0805JT82K0CT-ND | 10 | 0.017 | 0.17 | Digikey | Zach | RES SMD 82K OHM 5% 1/8W 0805
311-680KARCT-ND | 10 | 0.019 | 0.19 | Digikey | Zach | RES SMD 680K OHM 5% 1/8W 0805
P20981CT-ND | 10 | 0.204 | 2.04 | Digikey | Zach | RES SMD 470 OHM 0.5% 1/4W 0805
1276-6511-1-ND | 10 | 0.045 | 0.45 | Digikey | Zach | CAP CER 4700PF 50V X7R 0805
RMCF0805JT330KCT-ND | 10 | 0.017 | 0.17 | Digikey | Zach | RES SMD 330K OHM 5% 1/8W 0805
311-270KARCT-ND | 10 | 0.019 | 0.19 | Digikey | Zach | RES SMD 270K OHM 5% 1/8W 0805
RMCF0805JT22K0CT-ND | 10 | 0.017 | 0.17 | Digikey | Zach | RES SMD 22K OHM 5% 1/8W 0805
RMCF0805JT22R0CT-ND | 10 | 0.017 | 0.17 | Digikey | Zach | RES SMD 22 OHM 5% 1/8W 0805
1655-1360-1-ND | 16 | 0.125 | 2.00 | Digikey | Zach | DIODE GEN PURP 75V 250MA SOD123
541-3331-ND | 3 | 12.67 | 38.01 | Digikey | Zach | 8X2 BLUE CHARACTER OLED
RMCF0805JT1M00CT-ND | 10 | 0.017 | 0.17 | Digikey | Zach | RES SMD 1M OHM 5% 1/8W 0805
732-8039-1-ND | 10 | 0.1 | 1.00 | Digikey | Zach | CAP CER 10000PF 16V X7R 0805
296-13935-1-ND | 10 | 0.363 | 3.63 | Digikey | Zach | IC INVERTER HEX SHMTT-TRIG 14QFN
160-1176-1-ND | 10 | 0.281 | 2.81 | Digikey | Zach | LED RED CLEAR 0805 SMD
535-13456-6-ND | 5 | 2.54 | 12.70 | Digikey | Zach | CRYSTAL 8.0000MHZ 10PF SMD
EG1191-ND | 10 | 0.187 | 1.87 | Digikey | Zach | CAP PUSHBUTTON SQUARE BLACK
IC MCU STM32F072C8 | 1 |  | 8.85 |  | Andrew
