ECE411Team15/Speedometer/WPRs/naming_guide.txt

WPR naming convention: wk##_Name_WPR

eg 'wk03_Zach_WPR' for Zach's WPR submitted week 3.
