ECE411Team15/Speedometer/Homework 7/Software Test Diagram 2.0.docx

Software Test Diagram

Speed Demon Integration Test #3 (2.4)

Speed Demon Integration Test #1 (2.2)

Speed Demon Module Test #1 (2.1)

User Program Integration Test #2 (2.3)

ST-Link Interface (2.0)
