ECE411Team15/Speedometer/Homework 7/Software Test Diagram.docx

Software Test Diagram

Speed Demon Integration Test #3

Speed Demon Integration Test #1

Speed Demon Module Test #1

User Program Integration Test #2

ST-Link Interface
