ECE411Team15/Speedometer/EagleCAD/SpeedDemon/Main_PCB.pdf

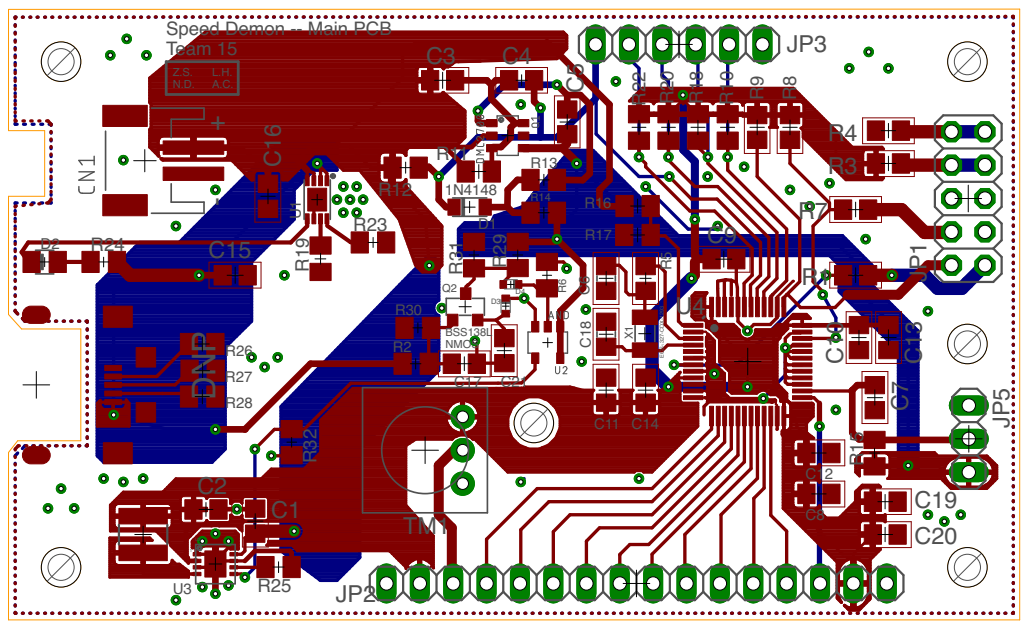
[picture p46: page 1]

DNP Speed Demon -- Main PCB Team 15 Z.S. N.D. L.H. A.C. U3 U1 + - D1 1N4148 BSS138L NMOS Q2 ECS-.327-CDX-1293 X1 1 D3 D4 C1 C10 C11 C12 C13 C14 C15 C16 C18 C2 C3 C4 C5 C6 C7 C8 D2 C9 JP1 JP2 JP3 JP5 R1 R10 R11 R12 R13 R14 R15 R16 R17 R18 R19 R20 R22 R23 R24 R25 R26 R27 R28 R29 R3 R30 R31 R32 R4 R5 R7 R8 R9 TM1 U4 C19 U3 C20 R2 C17 C21 R6
