ECE411Team15/Speedometer/EagleCAD/On_circuit_timing/on_button_timing.asc

C1: cap; 1µ
C2: cap; 100n
C3: cap; 1µ
C4: cap; 4.7µ
C5: cap; 10µ
D1: diode; 1N4148
D2: diode
D3: diode
M1: pmos; IRF7309P
M2: nmos; IRFH7914
M3: nmos; IRFH7914
R1: res; 270k
R2: res; 10k
R3: res; 470k
R4: res; 2.2k
R5: res; 10k
R6: res; 100k
R8: res; 1k
R9: res; 22k
R10: res; 82k
R11: res; 100k
S1: sw; MYSW
V1: voltage; PULSE(0 4 .1 1e-6 1e-6 10 10.1)
V2: voltage; PULSE(0 5 5 1E-6 1E-6 4 10); Rser=.1
V3: voltage; PULSE(0 4 1 1E-6 1E-6 .1 3 2); Rser=.1
V4: voltage; PULSE(0 5 5 1E-6 1E-6 1 10); Rser=100
Named nets: 0, V+, V_O, SW_ctrl, switching
.tran 10
.model MYSW SW(Ron=1 Roff=10Meg Vt=.5 Vh=-.4)
MOSFETS use DMC2700UDM-7 in SOT-23-6 package
Switch-off time determined by TC of C3 and R3
1N4148 or equivalent
Added R9 and C4, changed value of R10
