ECE411Team15/Speedometer/EagleCAD/SpeedDemon/Main_PCB_v2.brd

## EAGLE design EagleCAD/SpeedDemon/Main_PCB_v2.brd (2017-12-05)

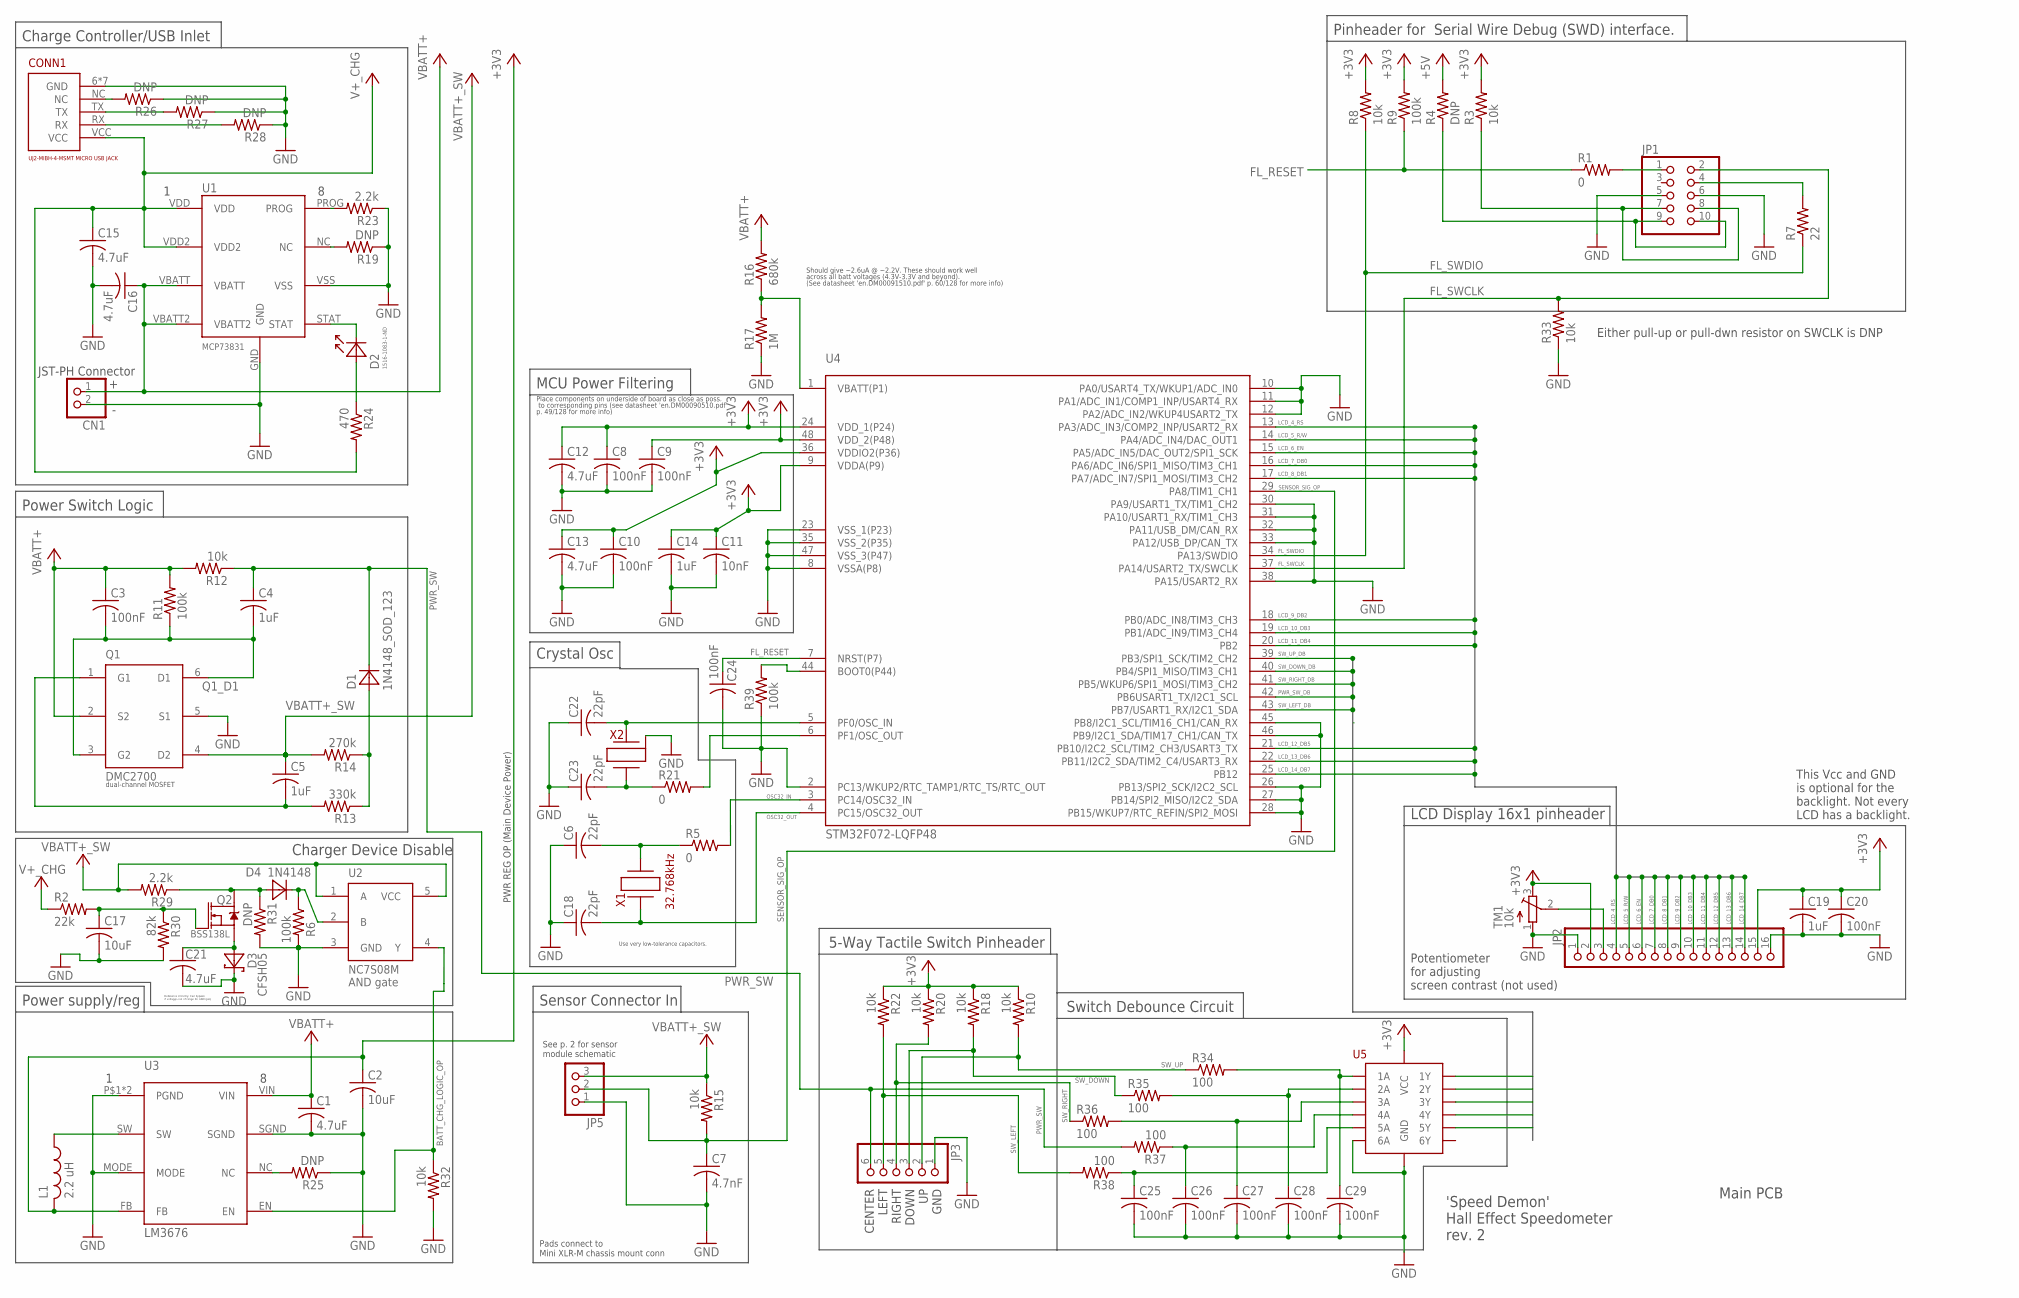
[picture p47: schematic Main_PCB_v2.sch]

Parts:
C1, C12, C13, C15, C16, C21: 4.7uF; C_0805
C2, C17: 10uF; C_0805
C3, C8, C9, C10, C20, C24, C25, C26, C27, C28, C29: 100nF; C_0805
C4, C5, C14, C19: 1uF; C_0805
C6, C18, C22, C23: 22pF; C_0805
C7: 4.7nF; C_0805
C11: 10nF; C_0805
CN1: JST_2PIN-SMT-RA; JST-PH-2-SMT-RA
CONN1: USB_JACK_102-4008-1-ND_USB-MICRO-B; USB_JACK_102-4008-1-ND_UJ2-MIBH-4-MSMT-TR
D1: 1N4148_SOD_123; D_SOD_123
D2: LED_0805
D3: CFSH05; SOD-882
D4: 1N4148; D_SOD_123
JP1: PINHD-2X5; 2X05
JP2: PINHD-1X16; 1X16
JP3: PINHD-1X6; 1X06
JP5: PINHD-1X3; 1X03
L1: 2.2 uH; NONSTANDARD_IND
Q1: DMC2700; SOT-23-6
Q2: BSS138L; TO-236
R1, R5: 0; R0805
R2: 22k; R_0805
R3, R8, R33: 10k; R0805
R4: DNP; R0805
R6, R11, R39: 100k; R_0805
R7: 22; R0805
R9: 100k; R0805
R10, R12, R15, R18, R20, R22, R32: 10k; R_0805
R13: 330k; R_0805
R14: 270k; R_0805
R16: 680k; R_0805
R17: 1M; R_0805
R19, R25, R26, R27, R28, R31: DNP; R_0805
R21: 0; R_0805
R23, R29: 2.2k; R_0805
R24: 470; R_0805
R30: 82k; R_0805
R34, R35, R36, R37, R38: 100; R_0805
TM1: 10k; TRIM-3386
U1: MCP73831_8-DFN; 8-DFN-(2X3)
U2: NC7S08M; SOT-23-5
U3: LM3676; WSON
U4: STM32F072-LQFP48; LQFP48
U5: SN74LV14A_HEX_SHMITT; S-PVFQN-N14
X1: 32.768kHz; CRYSTAL_OSC_3.2X1.5
X2: ABM3B-8.000MHZ-10-D-1-G-T; 4-SMD

Connections:
+3V3: C2.1, C8.1, C9.1, C10.1, C11.1, C12.1, C13.1, C14.1, C19.1, C20.1, JP2.2, JP2.15, L1.P$2 (2), R3.2, R8.2, R9.2, R10.1, R18.1, R20.1, R22.1, TM1.3 (E), U3.FB, U4.9 (VDDA(P9)), U4.24 (VDD_1(P24)), U4.36 (VDDIO2(P36)), U4.48 (VDD_2(P48)), U5.P$14 (VCC)
+5V: R4.2
+V+_CHG: C15.1, CONN1.VCC, R2.1, R24.2, U1.VDD, U1.VDD2
BATT_CHG_LOGIC_OP: R32.1, U2.4 (Y), U3.EN
FL_RESET: C24.1, R1.1, R9.1, U4.7 (NRST(P7))
FL_SWCLK: JP1.2, R33.2, U4.37 (PA14/USART2_TX/SWCLK)
FL_SWDIO: R7.1, R8.1, U4.34 (PA13/SWDIO)
GND: C1.2, C2.2, C6.1, C7.2, C8.2, C9.2, C10.2, C11.2, C12.2, C13.2, C14.2, C15.2, C16.2, C17.2, C18.1, C19.2, C20.2, C21.2, C22.1, C23.1, C24.2, C25.2, C26.2, C27.2, C28.2, C29.2, CN1.2 (1), CONN1.6 (GND), CONN1.7 (GND), CONN1.8 (GND), CONN1.9 (GND), CONN1.10 (GND), CONN1.11 (GND), CONN1.GND, D3.P$2 (C), JP1.5, JP1.6, JP2.1, JP2.16, JP3.1, JP5.1, Q1.5 (S1), R6.2, R17.1, R19.1, R23.1, R25.1, R26.1, R27.1, R28.1, R30.2, R31.2, R32.2, R33.1, R39.1, TM1.1 (A), U1.GND, U1.VSS, U2.3 (GND), U3.MODE, U3.P$1 (PGND), U3.PGND, U3.SGND, U4.2 (PC13/WKUP2/RTC_TAMP1/RTC_TS/RTC_OUT), U4.8 (VSSA(P8)), U4.10 (PA0/USART4_TX/WKUP1/ADC_IN0), U4.11 (PA1/ADC_IN1/COMP1_INP/USART4_RX), U4.12 (PA2/ADC_IN2/WKUP4USART2_TX), U4.23 (VSS_1(P23)), U4.26 (PB13/SPI2_SCK/I2C2_SCL), U4.27 (PB14/SPI2_MISO/I2C2_SDA), U4.28 (PB15/WKUP7/RTC_REFIN/SPI2_MOSI), U4.30 (PA9/USART1_TX/TIM1_CH2), U4.31 (PA10/USART1_RX/TIM1_CH3), U4.32 (PA11/USB_DM/CAN_RX), U4.33 (PA12/USB_DP/CAN_TX), U4.35 (VSS_2(P35)), U4.38 (PA15/USART2_RX), U4.45 (PB8/I2C1_SCL/TIM16_CH1/CAN_RX), U4.46 (PB9/I2C1_SDA/TIM17_CH1/CAN_TX), U4.47 (VSS_3(P47)), U5.GND, U5.P$7 (GND), U5.P$13 (6A), X2.P$02, X2.P$04
LCD_4_RS: JP2.4, U4.13 (PA3/ADC_IN3/COMP2_INP/USART2_RX)
LCD_5_R/W: JP2.5, U4.14 (PA4/ADC_IN4/DAC_OUT1)
LCD_6_EN: JP2.6, U4.15 (PA5/ADC_IN5/DAC_OUT2/SPI1_SCK)
LCD_7_DB0: JP2.7, U4.16 (PA6/ADC_IN6/SPI1_MISO/TIM3_CH1)
LCD_8_DB1: JP2.8, U4.17 (PA7/ADC_IN7/SPI1_MOSI/TIM3_CH2)
LCD_9_DB2: JP2.9, U4.18 (PB0/ADC_IN8/TIM3_CH3)
LCD_10_DB3: JP2.10, U4.19 (PB1/ADC_IN9/TIM3_CH4)
LCD_11_DB4: JP2.11, U4.20 (PB2)
LCD_12_DB5: JP2.12, U4.21 (PB10/I2C2_SCL/TIM2_CH3/USART3_TX)
LCD_13_DB6: JP2.13, U4.22 (PB11/I2C2_SDA/TIM2_C4/USART3_RX)
LCD_14_DB7: JP2.14, U4.25 (PB12)
unnamed: C5.2, Q1.1 (G1), R13.2
unnamed: JP1.1, R1.2
unnamed: JP1.9, JP1.10, R4.1
unnamed: R5.2, U4.3 (PC14/OSC32_IN)
unnamed: JP1.7, JP1.8, R3.1
unnamed: R16.1, R17.2, U4.1 (VBATT(P1))
unnamed: JP1.4, R7.2
unnamed: R39.2, U4.44 (BOOT0(P44))
unnamed: D4.2 (C), R6.1, U2.2 (B)
unnamed: L1.P$1 (1), U3.SW
unnamed: R21.2, U4.6 (PF1/OSC_OUT)
unnamed: JP2.3, TM1.2 (S)
unnamed: D1.1 (A), R13.1, R14.1
unnamed: C17.1, Q2.1 (G), R2.2, R30.1
unnamed: C22.2, U4.5 (PF0/OSC_IN), X2.P$01 (1)
unnamed: C23.2, R21.1, X2.P$03 (2)
unnamed: D4.1 (A), Q2.3 (D), R29.1, R31.1
unnamed: C21.1, D3.P$1 (A), Q2.2 (S)
unnamed: C25.1, R38.1, U5.P$11 (5A)
unnamed: C26.1, R37.1, U5.P$9 (4A)
unnamed: C27.1, R36.2, U5.P$5 (3A)
unnamed: C28.1, R35.2, U5.P$3 (2A)
unnamed: C29.1, R34.2, U5.P$1 (1A)
unnamed: D2.2 (C), U1.STAT
unnamed: R19.2, U1.NC
unnamed: D2.1 (A), R24.1
unnamed: R23.2, U1.PROG
unnamed: R25.2, U3.NC
unnamed: CONN1.NC, R26.2
unnamed: CONN1.TX, R27.2
unnamed: CONN1.RX, R28.2
OSC32_IN: C6.2, R5.1, X1.P$1 (1)
OSC32_OUT: C18.2, U4.4 (PC15/OSC32_OUT), X1.P$2 (2)
PWR_SW: C4.1, D1.2 (C), JP3.6, R12.1, R37.2
PWR_SW_DB: U4.42 (PB6USART1_TX/I2C1_SCL), U5.P$8 (4Y)
Q1_D1: C3.2, C4.2, Q1.3 (G2), Q1.6 (D1), R11.1
SENSOR_SIG_OP: C7.1, JP5.2, R15.2, U4.29 (PA8/TIM1_CH1)
SW_DOWN: JP3.3, R18.2, R35.1
SW_DOWN_DB: U4.40 (PB4/SPI1_MISO/TIM3_CH1), U5.P$4 (2Y)
SW_LEFT: JP3.5, R22.2, R38.2
SW_LEFT_DB: U4.43 (PB7/USART1_RX/I2C1_SDA), U5.P$10 (5Y)
SW_RIGHT: JP3.4, R20.2, R36.1
SW_RIGHT_DB: U4.41 (PB5/WKUP6/SPI1_MOSI/TIM3_CH2), U5.P$6 (3Y)
SW_UP: JP3.2, R10.2, R34.1
SW_UP_DB: U4.39 (PB3/SPI1_SCK/TIM2_CH2), U5.P$2 (1Y)
VBATT+: C1.1, C3.1, C16.1, CN1.1 (2), Q1.2 (S2), R11.2, R12.2, R16.2, U1.VBATT, U1.VBATT2, U3.VIN
VBATT+_SW: C5.1, JP5.3, Q1.4 (D2), R14.2, R15.1, R29.2, U2.1 (A), U2.5 (VCC)

Notes on the sheet:
Pinheader for Serial Wire Debug (SWD) interface.
Power supply/reg
Power Switch Logic
Place components on underside of board as close as poss.
to corresponding pins (see datasheet 'en.DM00090510.pdf'
p. 49/128 for more info)
MCU Power Filtering
Should give ~2.6uA @ ~2.2V. These should work well
across all batt voltages (4.3V-3.3V and beyond).
(See datasheet 'en.DM00091510.pdf' p. 60/128 for more info)
This Vcc and GND is optional for the backlight. Not every LCD has a backlight.
Potentiometer for adjusting screen contrast (not used)
LCD Display 16x1 pinheader
5-Way Tactile Switch Pinheader
dual-channel MOSFET
Charge Controller/USB Inlet
Charger Device Disable
PWR REG OP (Main Device Power)
Sensor Connector In
Pads connect to Mini XLR-M chassis mount conn
'Speed Demon' Hall Effect Speedometer rev. 2
Main PCB
See p. 2 for sensor module schematic
Crystal Osc
CENTER LEFT RIGHT DOWN UP GND
Use very low-tolerance capacitors.
JST-PH Connector
Debounce circuitry. Can bypass if voltages out of range for AND gate.
Either pull-up or pull-dwn resistor on SWCLK is DNP
Switch Debounce Circuit

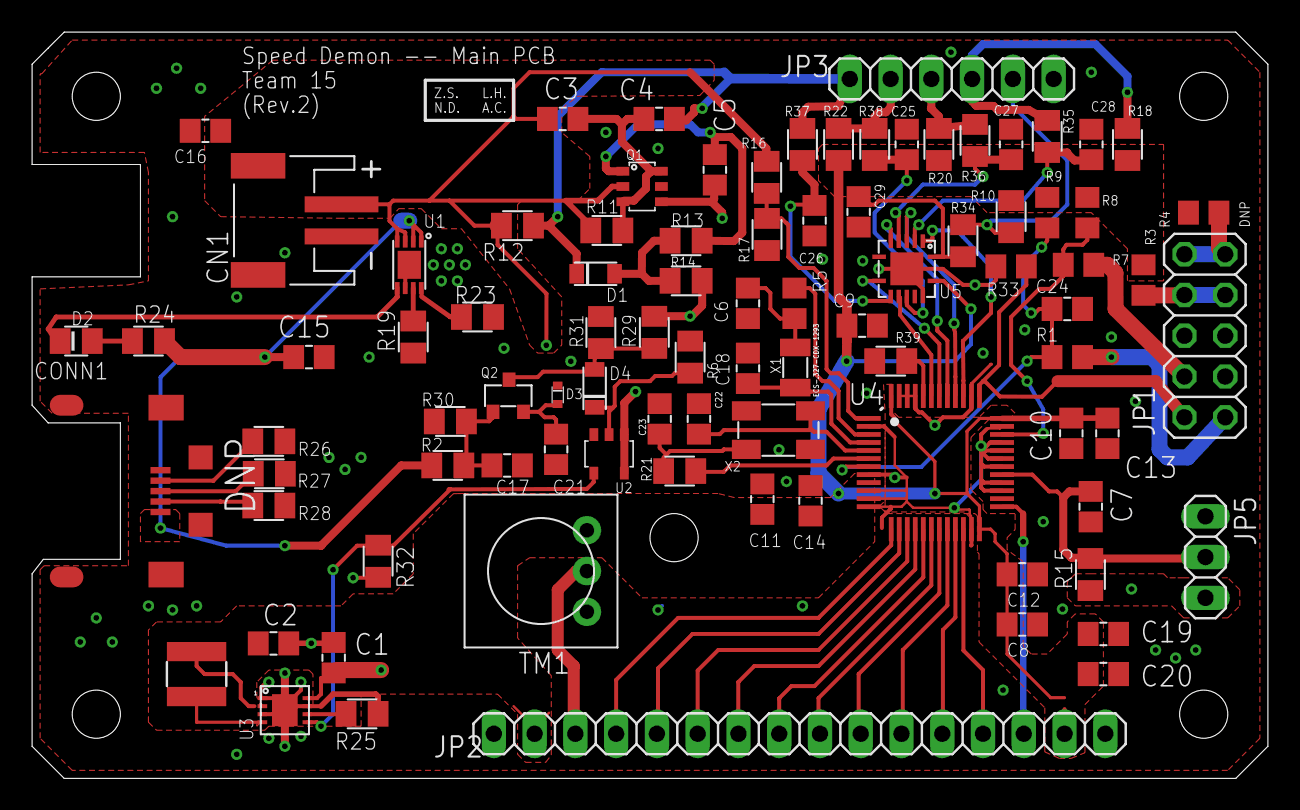
[picture p48: board Main_PCB_v2.brd from above]

Board: 2 copper layers, 77.0 x 46.5 mm, 89 parts (0 on the bottom side), 65 nets.
