ECE411Team15/Speedometer/EagleCAD/SpeedDemon/sensor circuit.brd

## EAGLE design EagleCAD/SpeedDemon/sensor circuit.brd (2017-11-04)

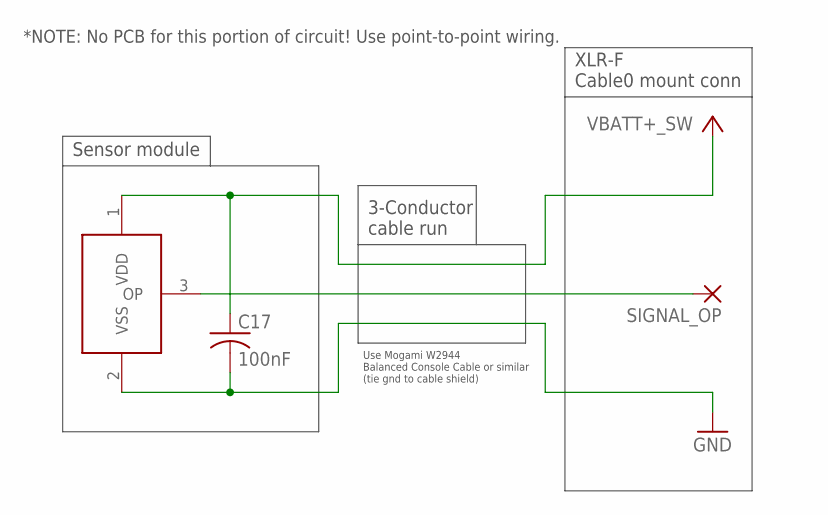
[picture p49: schematic sensor circuit.sch]

Parts:
C17: 100nF; C025-024X044
SIGNAL_OP: 1,6/0,8
U1A: US5881; TO-92

Connections:
GND: C17.2, U1A.2 (VSS)
unnamed: SIGNAL_OP.1, U1A.3 (OP)
VBATT+_SW: C17.1, U1A.1 (VDD)

Notes on the sheet:
Sensor module
XLR-F Cable0 mount conn
3-Conductor cable run
Use Mogami W2944 Balanced Console Cable or similar (tie gnd to cable shield)
*NOTE: No PCB for this portion of circuit! Use point-to-point wiring.

Board: 2 copper layers, 3 parts (0 on the bottom side), 3 nets, no tracks yet.
