ECE411Team15/Speedometer/(commit log)

2017-10-10 Adding my Data Log
    This log is for the work Andrew Capatina will be performing. The log keeps track of basic information needed for our project.
2017-10-10 Initial Hall Sensor Reading
    Graph of voltage output for hall effect sensor.
2017-10-12 added EagleCAD files for MCU dev board
    [Practicum_MC_protoboard.brd, Practicum_MC_protoboard.sch]
2017-10-12 added CNC mill files for dev board
2017-10-13 modified dev board layout slightly
    [Practicum_MC_protoboard.brd]
2017-10-14 final version of MCU dev board
    [Practicum_MC_protoboard.brd]
2017-10-14 Sensor Data
    Latest test run with U58 sensor
2017-10-14 Sensor Data
    Latest test data from U58
2017-10-15 Updated BOM
    [Bill of Material.xlsx]
2017-10-19 Week 4 WPR
    ¯\_(ツ)_/¯
2017-10-20 First version of eaglecad schematic
    [Bill of Material.xlsx, Schematic.sch]
2017-10-20 Changed folder name from "schematic" to "EagleCAD" because we are storing the entire Eagle project here.
    [Practicum_MC_protoboard.brd, Practicum_MC_protoboard.sch, Schematic.sch]
2017-10-21 small schem update
    [Schematic.sch]
2017-10-21 schematic changes
    [Practicum_MC_protoboard.brd, Practicum_MC_protoboard.sch, Schematic.sch]
2017-10-21 Zach and I started the EagleCAD schematic.
    [Schematic.sch]
2017-10-21 This is the switching voltage regulator I made.
2017-10-21 Zach I modified the schematic and added the Serial Wire Debug (SWD) connections based off Linyi's document. Let me know what you think. We should double check this together.
    [Schematic.sch]
2017-10-21 Zach checkout the schematic. I added the SWD connections. We should review this together.
    [Schematic.sch]
2017-10-21 added partial power circuit to schematic, added 0805_generics.lbr (generic 0805 SMD RCL parts) to EagleCAD folder
    [Schematic.sch]
2017-10-21 added work-in-progress circuit sim for on button timing
2017-10-22 Added LTSpice sim of working power switching control circuit
2017-10-22 added datasheet for DMC2700UDM.pdf (dual-channel MOS package) for power-on circuit
2017-10-22 Added power switch logic to schematic (mostly done). Added related parts to new library.
    [Schematic.sch]
2017-10-22 Added 1n4148 SMD package to library and to power button schematic
    [Schematic.sch]
2017-10-23 More added to schem, incl. power scheme for MCU and seonsor input section. NOTE: Working SMD passives library has been renamed LCRD_SMD_generics.lbr
    [Schematic.sch]
2017-10-23 MCU pinout
    Pinout needed for schematic
2017-10-23 Made revision
    Included pins for IO power and ground.
2017-10-23 Added WPR, tested dual output for mode/pwr switch (it works as SPST if it's properly buffered!)
2017-10-23 lab test data of power on circuit added (it works)
2017-10-23 edit switch lab results
2017-10-23 Added thermal pad to switching regulator library part. Updated schematic.
    [Schematic.sch]
2017-10-24 added results of test build for charger power interrupt
2017-10-24 updated LTSpice power control schematic to include charger interrupt (not pictured: AND gate on output).
2017-10-25 Added LCD and 5-way button to schematic.
    [Schematic.sch]
2017-10-25 5-way tactile switch library.
2017-10-25 Power section of schematic finished. Some parts added to libraries.
    [Schematic.sch]
2017-10-25 Schematic update, passed ERC. Added second page with sensor module. Added several parts libraries.
    [Schematic.sch]
2017-10-25 tiny edits
    [Schematic.sch]
2017-10-25 Fixed frame of second page
    [Schematic.sch]
2017-10-26 Copy of schematic for class assignment.
    [Schematic.sch]
2017-10-26 added direct link to schematic on front page
2017-10-31 added external OSC circuit to schematic, several datasheets
    [Schematic.sch]
2017-11-01 Updated the 5-way button
    [Schematic.sch]
2017-11-01 Updated 5-way tactile switch
    [Schematic.sch]
2017-11-01 Schematic updates, labeling, bus bars. ERC passed. Nathan will finalize tonight.
    [Schematic.sch]
2017-11-02 Updated battery connector.
    [Schematic.sch]
2017-11-02 Added in some parts that we'll need to order soon.
    [Bill of Material.xlsx]
2017-11-03 The breakout board for the 5-way tactile switch is complete. Check it out.
    [Schematic.brd, Schematic.sch]
2017-11-03 Started a board layout
    [Schematic.brd, Schematic.sch]
2017-11-03 Modded switch breakout board, sent design away. Also added OSHPark design rules file
    [Schematic.brd]
2017-11-04 Added 5-way tactile switch order.
    [Bill of Material.xlsx]
2017-11-04 board layout.. needs some work
    [Schematic.brd, Schematic.sch]
2017-11-04 Draft layout. Moved power reg circuit as far away from everything else as possible to minimize possible noise issues. Also poured polygons for power planes
    [Main_PCB.brd, Main_PCB.sch, sensor circuit.brd, sensor circuit.sch]
2017-11-05 fixed inductor choice, picked one that meets spec for the pwr converter
    [Main_PCB.brd, Main_PCB.sch, proto-BOM.xlsx]
2017-11-05 Zach I added stitching vias to stitch the top and bottom gnd planes together. I also made the board smaller by pulling the top down and shifting components.
    [Main_PCB_v.2.brd]
2017-11-05 Fixed drill hole
    [Main_PCB_v.2.brd]
2017-11-05 Fixed drill holes
    [Main_PCB_v.2.brd]
2017-11-05 Incorporated Nathan's v.2 revs and also did some more power planing
    [Main_PCB_V.3.brd]
2017-11-05 Fixed several DRC errors
    [Main_PCB.brd, Main_PCB_V.3.brd]
2017-11-06 BOM additions
    [Bill of Material.xlsx, proto-BOM.xlsx]
2017-11-06 board revisions, potential switch cap datasheet
    [Main_PCB_V.3.brd]
2017-11-07 added basic mechanical drawings (no Z dimension) to allow beginning case design
    [mechanical_tactile_switch_board.brd, mechanical_tactile_switch_board.sch, mechanicals_main_board.brd]
2017-11-08 Added level 1 power supply.
2017-11-09 HW5 added
    [Main_PCB.brd, Main_PCB_V.3.brd, Main_PCB_v.2.brd]
2017-11-12 updated schematic/layout with pwr inlet debounce circuit and added center switch connectivity to MCU. Other small organizational changes.
    [Main_PCB.brd, Main_PCB.sch]
2017-11-12 Changed layout to maximize distance between power inductor and everything else
    [Main_PCB.brd]
2017-11-12 several small changes to layout to improve ground planing
    [Main_PCB.brd]
2017-11-12 Added WPRs, finished changes for debounce circuit.
    [Main_PCB.brd, Main_PCB.sch]
2017-11-13 minor library/board tweaks
    [Main_PCB.sch]
2017-11-13 added 8MHz oscillator citcuit to layout and schematic
    [Main_PCB.brd, Main_PCB.sch]
2017-11-13 schematic/layout detail work.
    [Main_PCB.brd, Main_PCB.sch]
2017-11-13 final changes to power defeat logic
    [Main_PCB.brd, Main_PCB.sch]
2017-11-14 Prototype software
    For interfacing with LCD and hall effect sensor.
2017-11-15 Version 1.2 of prototype
    Added comments to code.
2017-11-15 final layout adjustments
    [Main_PCB.brd, Main_PCB.sch]
2017-11-16 final board
    [Main_PCB.brd]
2017-11-16 Ordered 4 Li-po batteries and 5 right-angle JST-PH connectors.
    [Bill of Material.xlsx]
2017-11-16 Final Board/schem. Includes added debounce circuit for 5-way switch.
    [Main_PCB.brd, Main_PCB.sch]
2017-11-16 tiny revision to final. SUBMITTED THIS VERSION TO FAB.
    [Main_PCB.brd]
2017-11-17 Merge branch 'master' of https://github.com/ECE411Team15/Speedometer
    # Conflicts:
    # Bill of Material.xlsx
    [Digikey_Order_11_16.xlsx]
2017-11-18 Added files for OSH stencil. Updated BOM, including total cost per team member.
    [Bill of Material.xlsx]
2017-11-21 moved case mechanical drawings to new root-level folder
    [mechanical_tactile_switch_board.brd, mechanical_tactile_switch_board.sch, mechanicals_main_board.brd]
2017-11-26 added quick sample graphic
2017-11-30 added updated schematic/layout to reflect board hacks
    [Main_PCB_v2.brd, Main_PCB_v2.sch]
2017-12-04 Updated some of my orders
    [Bill of Material.xlsx]
2017-12-05 BOM is almost complete. There are some things that need to be reviewed.
    [Bill of Material v.2.xlsx]
2017-12-06 Fixed the calculation for the cost of a single board.
    [Bill of Material v.3.xlsx]
2017-12-06 BOM adjustments
    [Bill of Material v.3.xlsx, Bill of Material.xlsx]
2018-01-09 I summed the total costs of what we each spent on the project.
    [Bill of Material v.3.xlsx]
2018-01-10 I added in the price of one more MCU that Andrew had purchased.
    [Bill of Material v.3.xlsx]
